alopezrivera/hopping_leg/docs/reference/source/chapters/2.hopping_control.rst

Hopping Control
===============

Hopping can be simplified with the Spring Loaded Inverted Pendulum (SLIP) model, in which a mass is mounted on a massless spring :cite:p:`Tedrake`. Due to this spring, the energy in the system stays constant. By adding or removing energy into the system, e.g., by applying some force to the spring, the jumping height can be controlled.

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

Gain Scheduling Control
-----------------------

The gain scheduling control uses Cartesian stiffness control to mirror the behaviour of the spring in the SLIP model. For this, a high stiffness is necessary to reapply sufficient energy into the system. To be able to lift-off and to counteract dissipation, the desired leg length during the lift-off phase can be increased and/or a feed forward force can be applied.

Energy Shaping Control
----------------------

The advantage of energy shaping control is, that we can control the jumping height by applying energy to the system until the desired energy :math:`E_{des}`, which is needed to jump at a desired height :math:`h_{des}`, is reached.
With the simplification, that we assume all mass `m` in the shoulder of the jumping leg the desired energy can be calculated with:

.. math::

    E_{des} = m g h_{des}

The used approach is non-continuous energy shaping, where we just observe the reached energy, which is: 

.. math::

    E \propto k F_e

and hence:

.. math:: 

    \dot E \propto \dot k F_e

Thus, we can add energy to the system by increasing `k` and remove energy by decreasing it. To control `k` the following update rule can be used:

.. math::

    k_{i+1} = k_{i}  (\frac{E_{des}}{E})^2
