alopezrivera/hopping_leg/docs/report/figures/hopping_leg.pdf

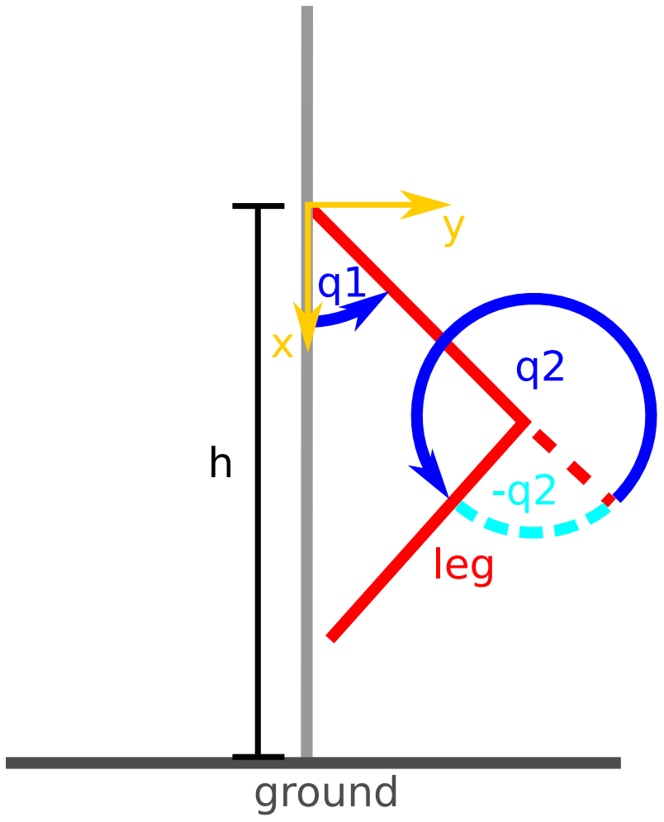
[picture p50: figure]
ground; leg
