alopezrivera/hopping_leg/docs/report/figures/hopping_leg_seq.pdf

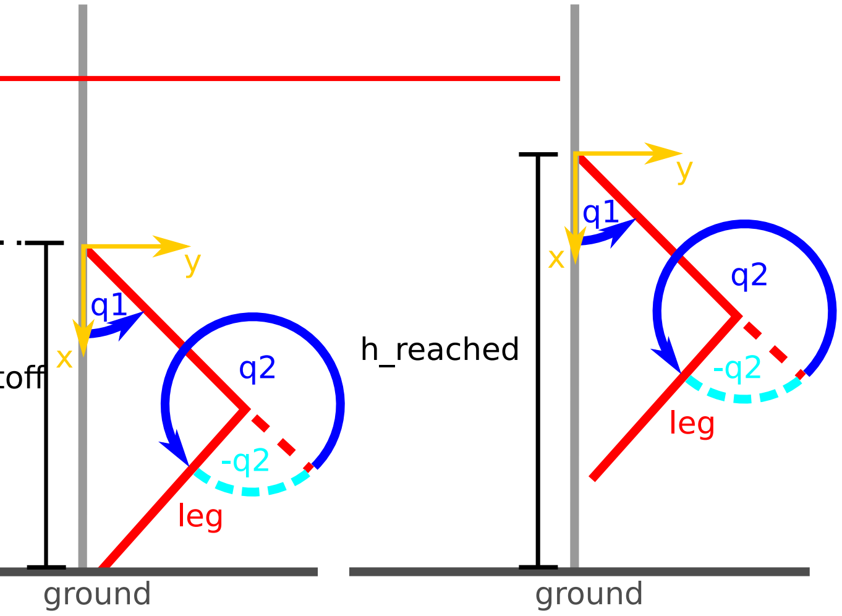
[picture p51: figure]
h_reached; ground; leg; toff
