alopezrivera/hopping_leg/hopping_leg/model/leg/without_rails/urdf/v6.pdf

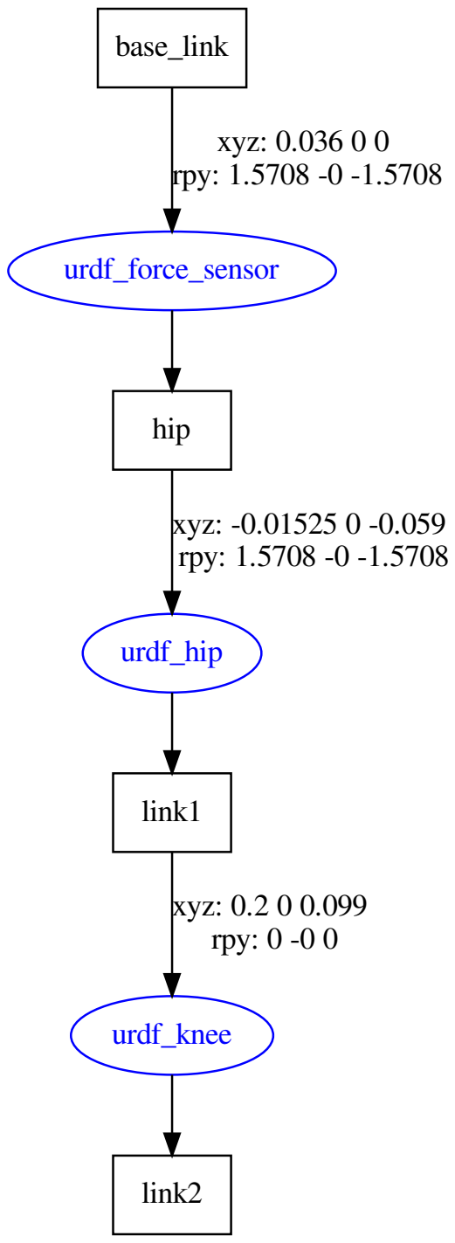
[picture p52: figure]
base_link; urdf_force_sensor; xyz: 0.036 0 0 rpy: 1.5708 -0 -1.5708; hip; urdf_hip; xyz: -0.01525 0 -0.059 rpy: 1.5708 -0 -1.5708; link1; urdf_knee; xyz: 0.2 0 0.099 rpy: 0 -0 0; link2
