alopezrivera/hopping_leg/docs/report/figures/sim0.4m/trajectoryexport.csv

time | shoulder_pos | elbow_pos | shoulder_vel | elbow_vel | shoulder_torque | elbow_torque
0.0014285714285714286 | -0.8964198657500071 | 1.783805794860055 | -3.82780511974532e-08 | -5.725540935109707e-07 | 1.275737367589555 | 4.722162462507789
0.002857142857142857 | -0.8972408415099087 | 1.7915024078758204 | -0.5746830319311426 | 5.387629111035757 | -0.17276516975831765 | -12.0
0.004285714285714286 | -0.8975892532870292 | 1.791522378884535 | -0.24388824398438447 | 0.013979706100228029 | 0.022556355161053598 | -12.0
0.005714285714285714 | -0.8975786801055714 | 1.7911083138747825 | 0.007401227020496837 | -0.28984550682670474 | 0.014718222825496464 | -12.0
0.007142857142857143 | -0.8972522583984869 | 1.790264468493122 | 0.22849519495919002 | -0.5906917671624932 | 0.009083692138998139 | -12.0
0.008571428571428572 | -0.8966414498656381 | 1.788993654238625 | 0.42756597299414256 | -0.8895699781477635 | 0.0050646211520992855 | -12.0
0.01 | -0.8957689195122812 | 1.7872975325958451 | 0.6107712473498346 | -1.187285149945966 | 0.0022198649754542436 | -12.0
0.011428571428571429 | -0.894650724335926 | 1.7851768291151866 | 0.7827366234486945 | -1.4844924364610002 | 0.0002199387344420817 | -12.0
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
