alopezrivera/hopping_leg/docs/report/figures/sim0.4m/acceleration.png

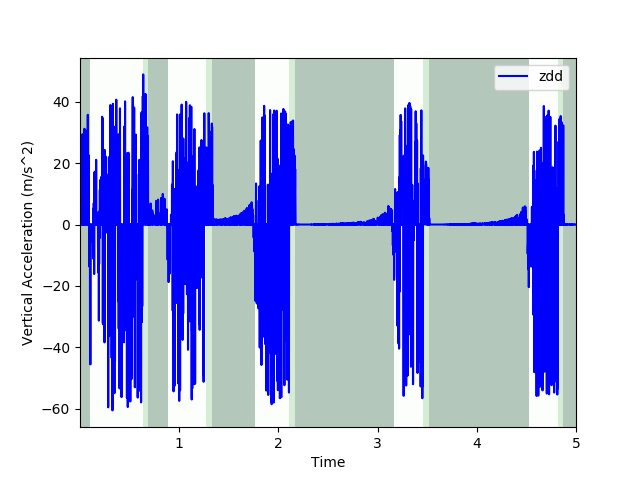
docs/report/figures/sim0.4m/acceleration.png
