alopezrivera/hopping_leg/docs/report/figures/sim0.4m/joint_velocities.png

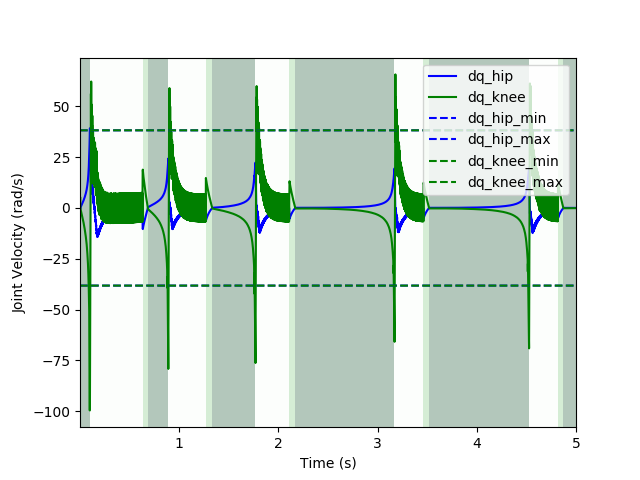
docs/report/figures/sim0.4m/joint_velocities.png
