alopezrivera/hopping_leg/docs/report/figures/sim0.4m/trajectory.png

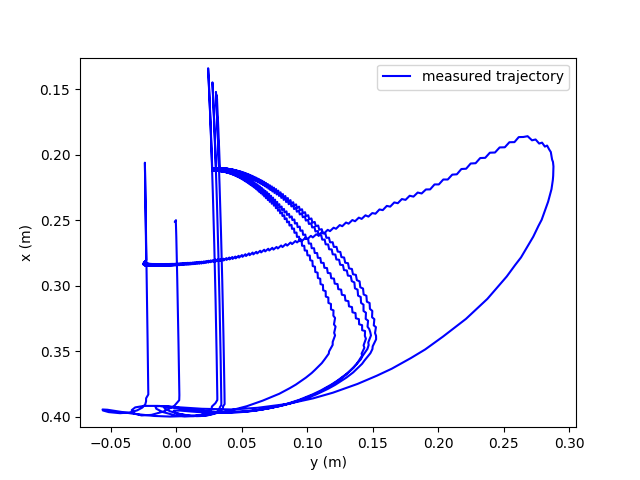
docs/report/figures/sim0.4m/trajectory.png
