alopezrivera/hopping_leg/docs/report/figures/sim0.4m/velocity.png

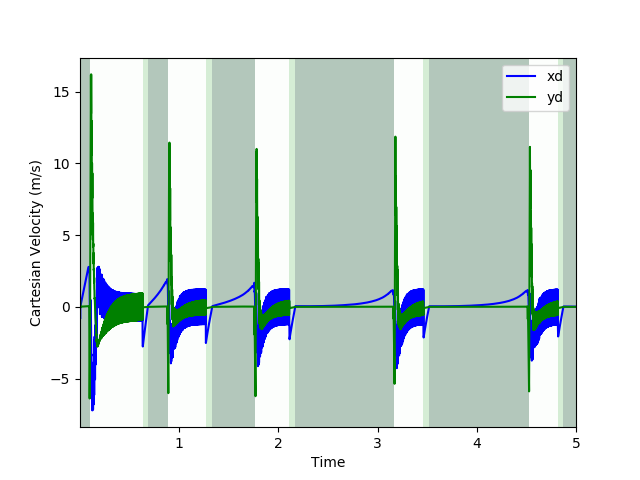
docs/report/figures/sim0.4m/velocity.png
