alopezrivera/hopping_leg/docs/report/figures/sim0.5m/acceleration.png

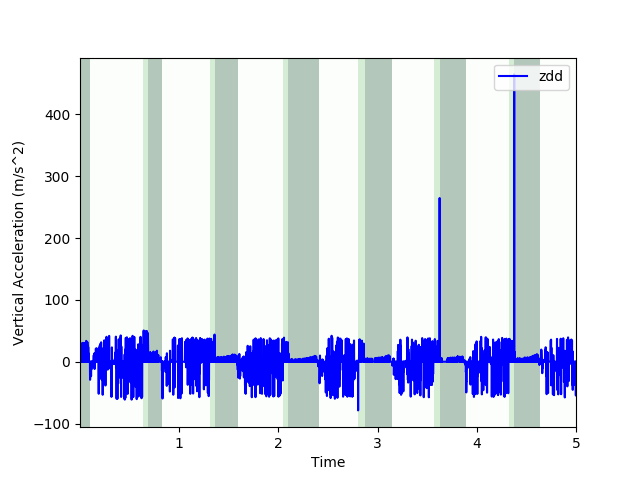
docs/report/figures/sim0.5m/acceleration.png
