alopezrivera/hopping_leg/docs/report/figures/sim0.5m/estimated_height.png

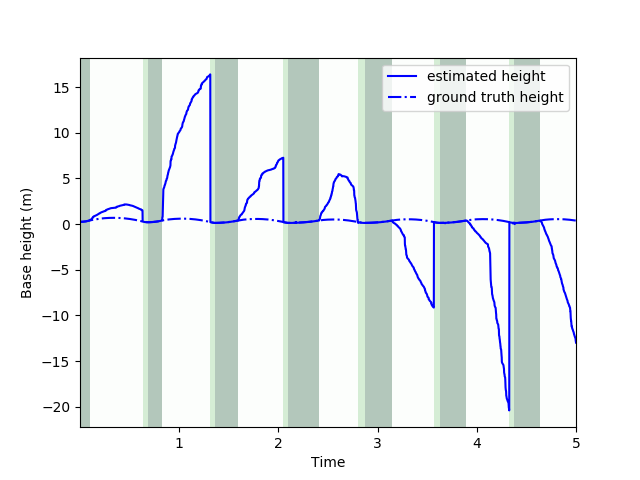
docs/report/figures/sim0.5m/estimated_height.png
