alopezrivera/hopping_leg/docs/report/figures/sim0.5m/joint_angles.png

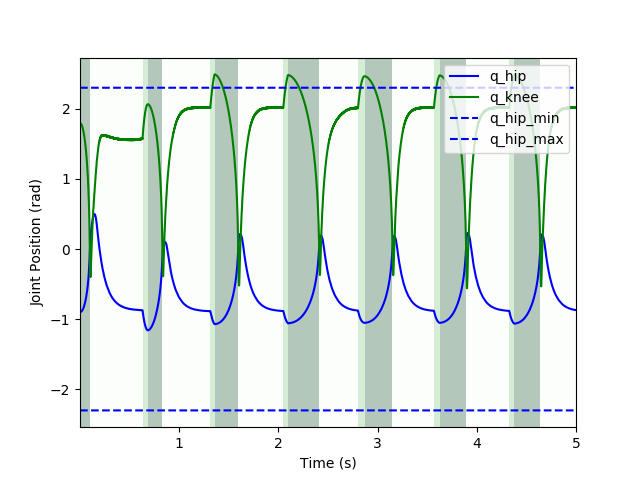
docs/report/figures/sim0.5m/joint_angles.png
