alopezrivera/hopping_leg/docs/report/figures/sim0.5m/joint_velocities.png

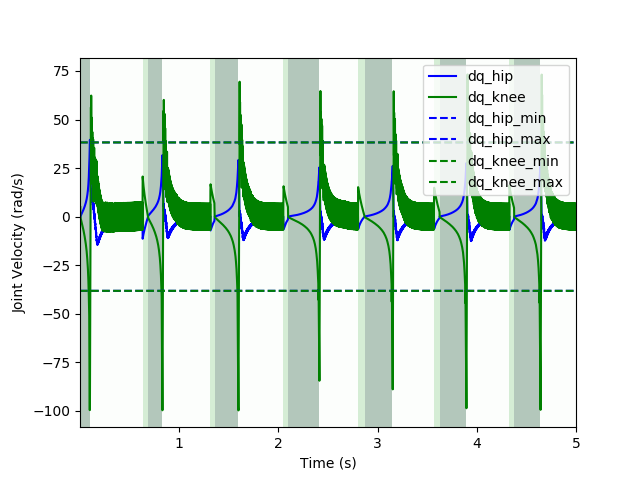
docs/report/figures/sim0.5m/joint_velocities.png
