alopezrivera/hopping_leg/docs/report/figures/sim0.5m/position.png

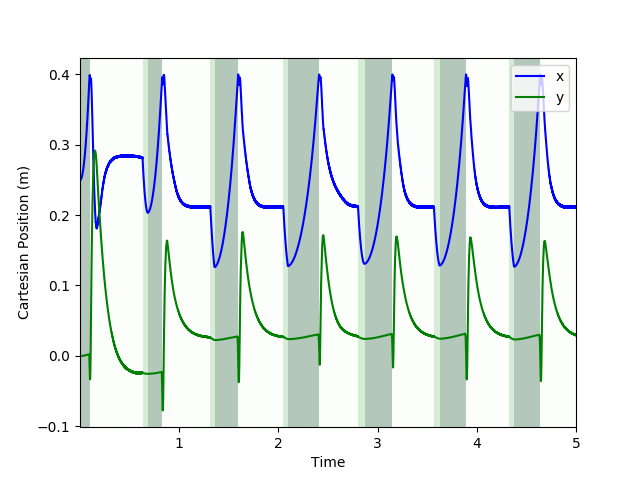
docs/report/figures/sim0.5m/position.png
