alopezrivera/hopping_leg/docs/report/figures/sim0.5m/trajectory.png

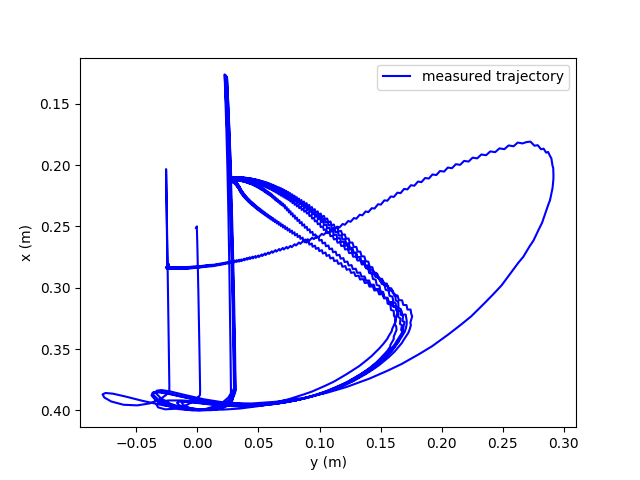
docs/report/figures/sim0.5m/trajectory.png
