alopezrivera/hopping_leg/docs/report/figures/sim0.5m/velocity.png

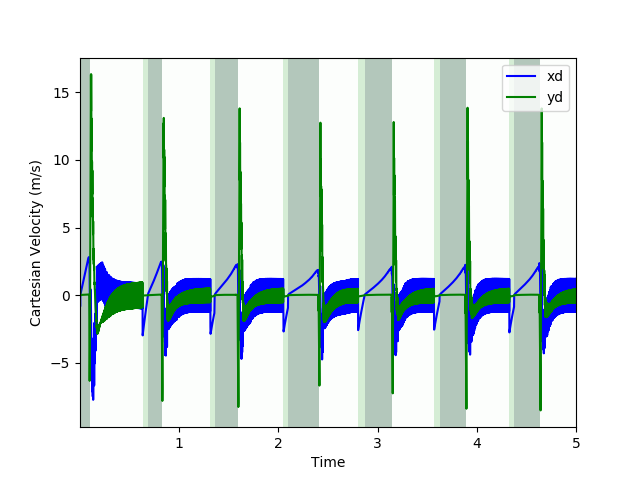
docs/report/figures/sim0.5m/velocity.png
