alopezrivera/hopping_leg/docs/report/figures/sim0.6m/acceleration.png

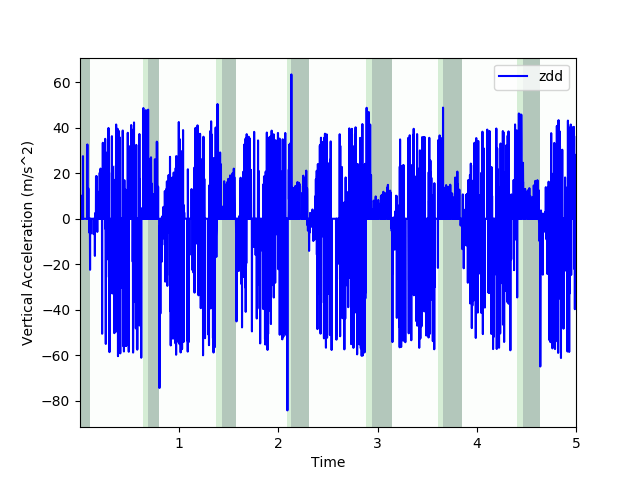
docs/report/figures/sim0.6m/acceleration.png
