alopezrivera/hopping_leg/docs/report/figures/sim0.6m/estimated_height.png

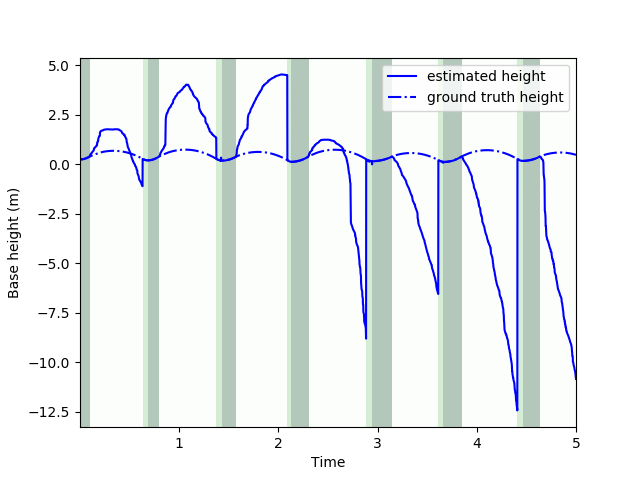
docs/report/figures/sim0.6m/estimated_height.png
