alopezrivera/hopping_leg/docs/report/figures/sim0.6m/joint_angles.png

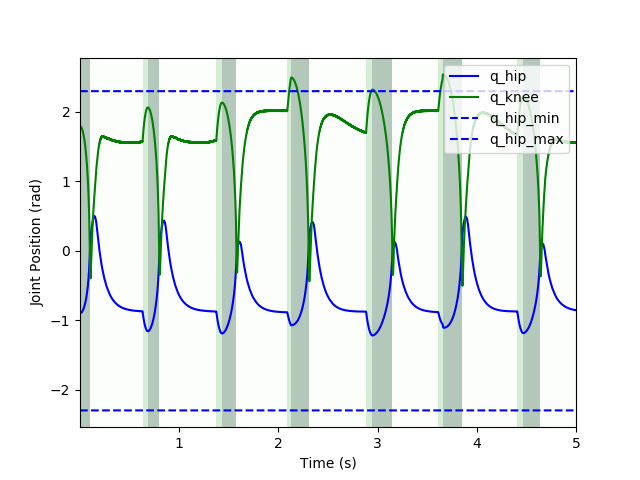
docs/report/figures/sim0.6m/joint_angles.png
