alopezrivera/hopping_leg/docs/report/figures/sim0.6m/position.png

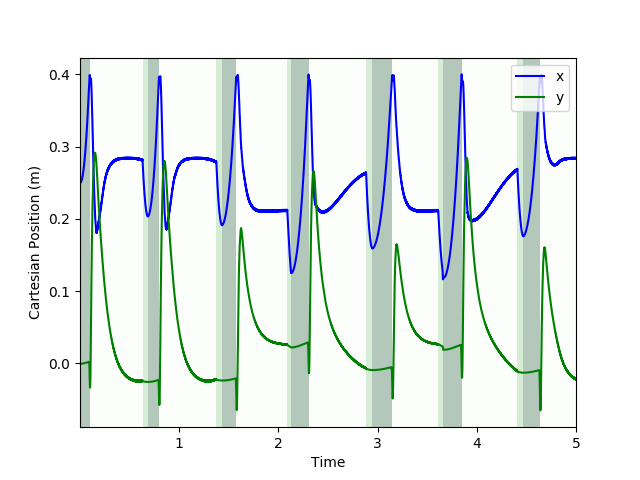
docs/report/figures/sim0.6m/position.png
