alopezrivera/hopping_leg/docs/report/figures/sim0.6m/reaction_forces.png

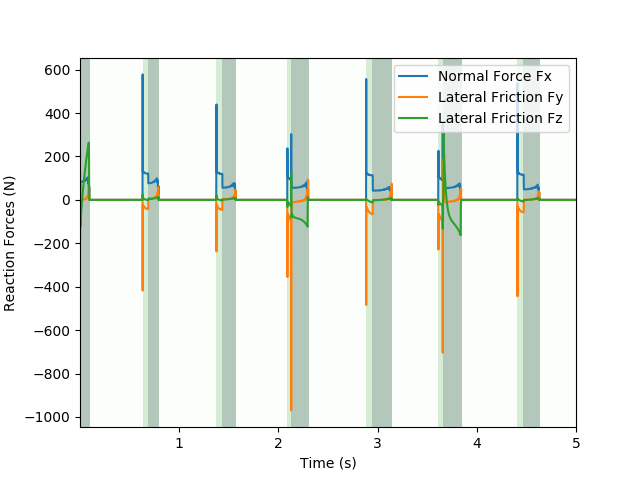
docs/report/figures/sim0.6m/reaction_forces.png
