alopezrivera/hopping_leg/docs/report/figures/sim0.6m/trajectory.png

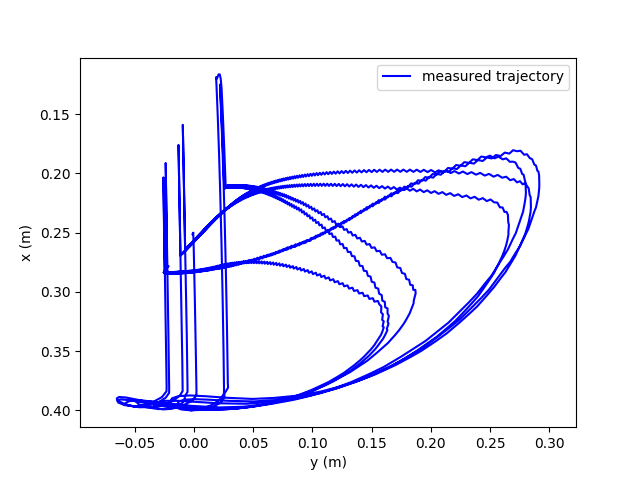
docs/report/figures/sim0.6m/trajectory.png
