alopezrivera/hopping_leg/docs/report/figures/sim0.6m/velocity.png

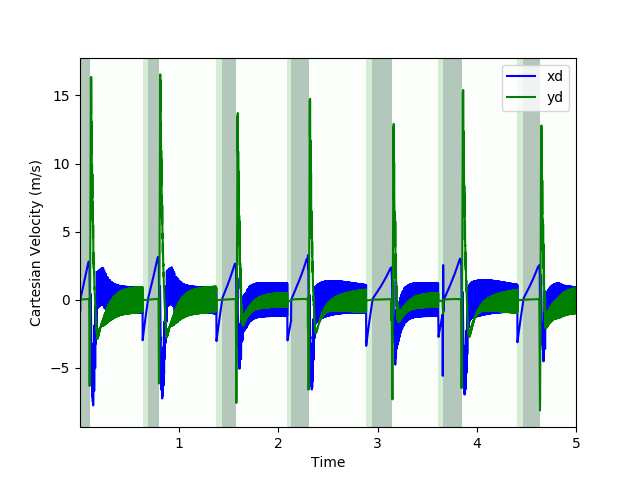
docs/report/figures/sim0.6m/velocity.png
