alopezrivera/hopping_leg/figures/plant/coordinates.png

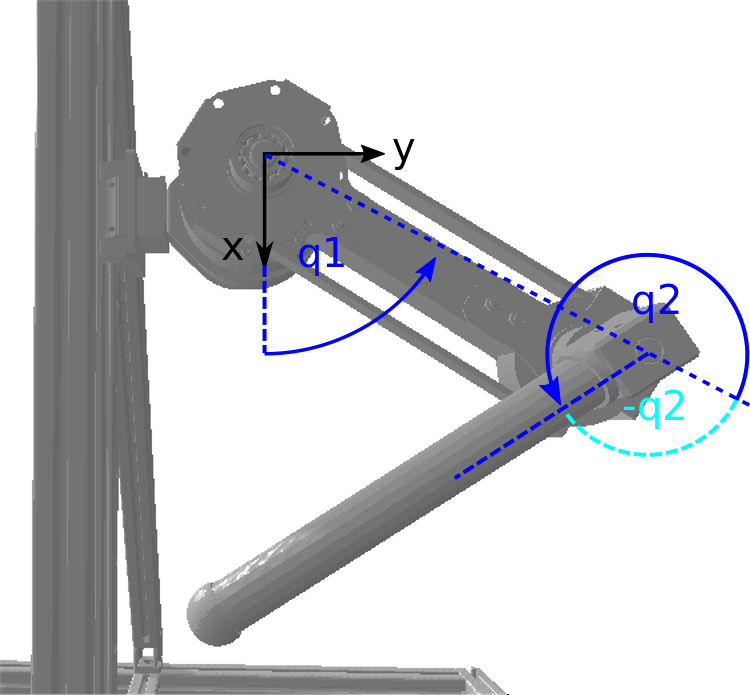
figures/plant/coordinates.png
