alopezrivera/hopping_leg/hopping_leg/controllers/OC_FDDP/comtraj.png

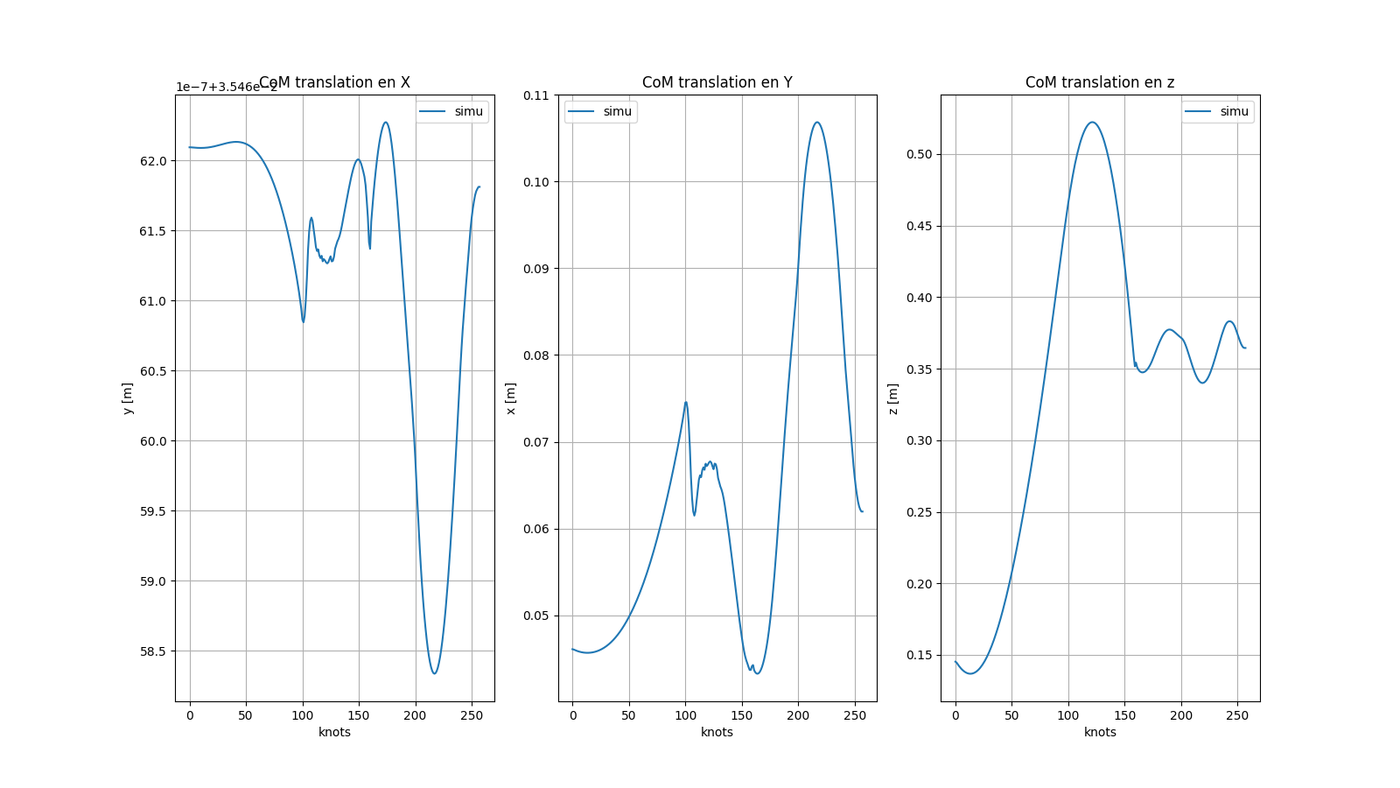
hopping_leg/controllers/OC_FDDP/comtraj.png
