alopezrivera/hopping_leg/hopping_leg/controllers/OC_FDDP/jointRotations.png

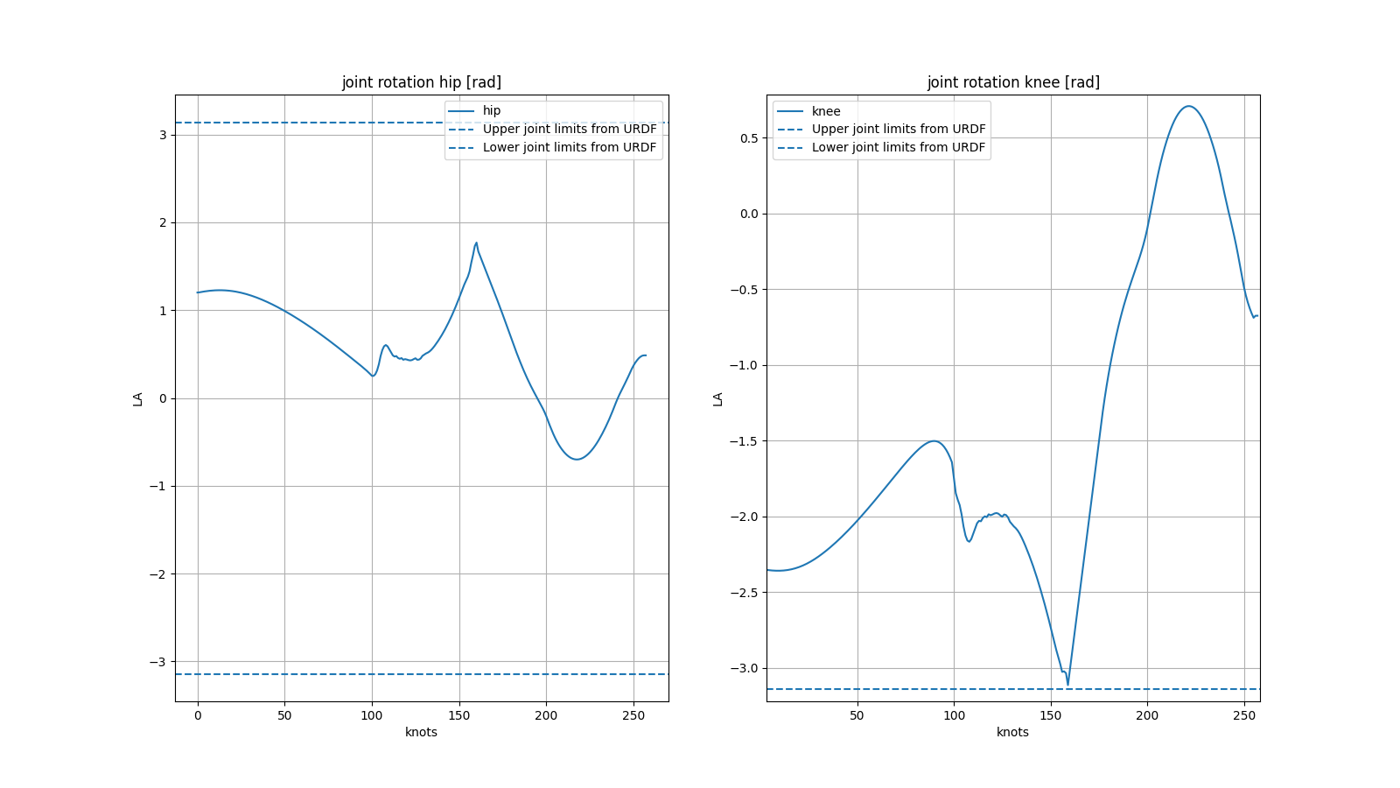
hopping_leg/controllers/OC_FDDP/jointRotations.png
