alopezrivera/hopping_leg/hopping_leg/controllers/OC_FDDP/jointVelocities.png

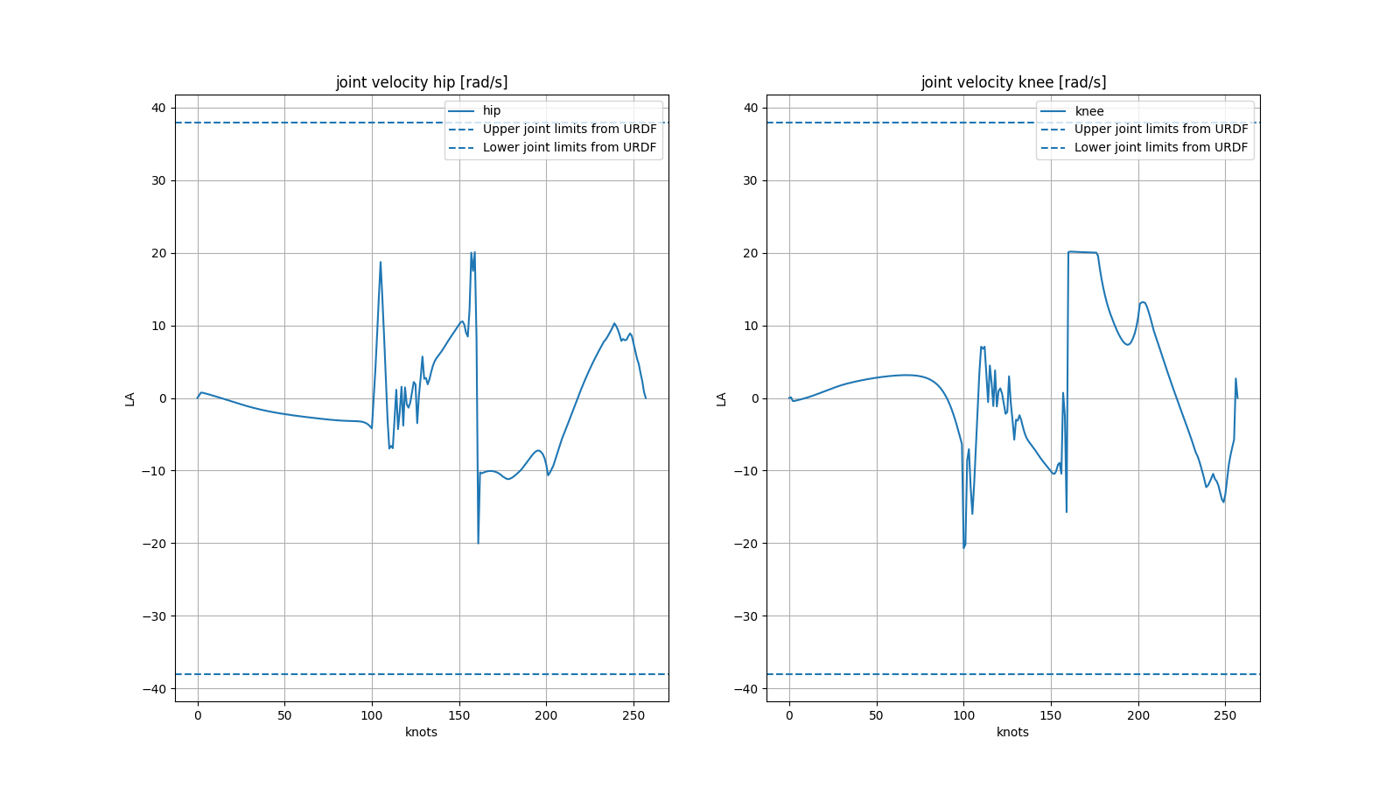
hopping_leg/controllers/OC_FDDP/jointVelocities.png
