alopezrivera/hopping_leg/hopping_leg/controllers/OC_FDDP/torques.png

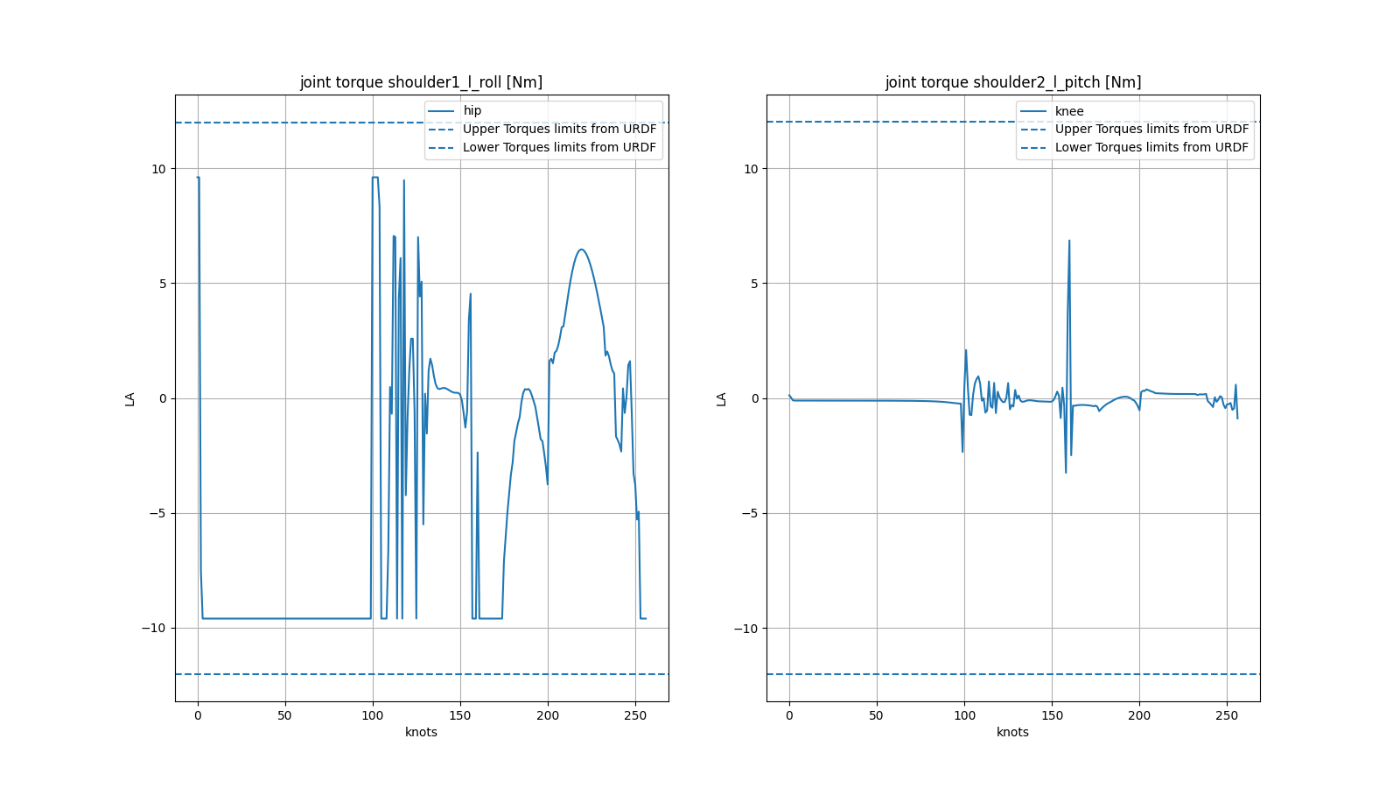
hopping_leg/controllers/OC_FDDP/torques.png
