alopezrivera/hopping_leg/hopping_leg/model/leg/with_rails/meshes/hip.STL

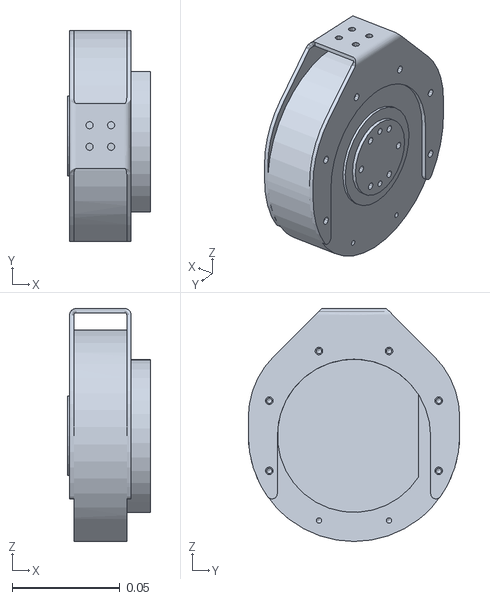
[picture p79: CAD file, 2022-03-21]
hopping_leg/model/leg/with_rails/meshes/hip.STL
0.0385 x 0.098 x 0.108
