alopezrivera/hopping_leg/hopping_leg/model/leg/with_rails2/meshes/link_1.STL

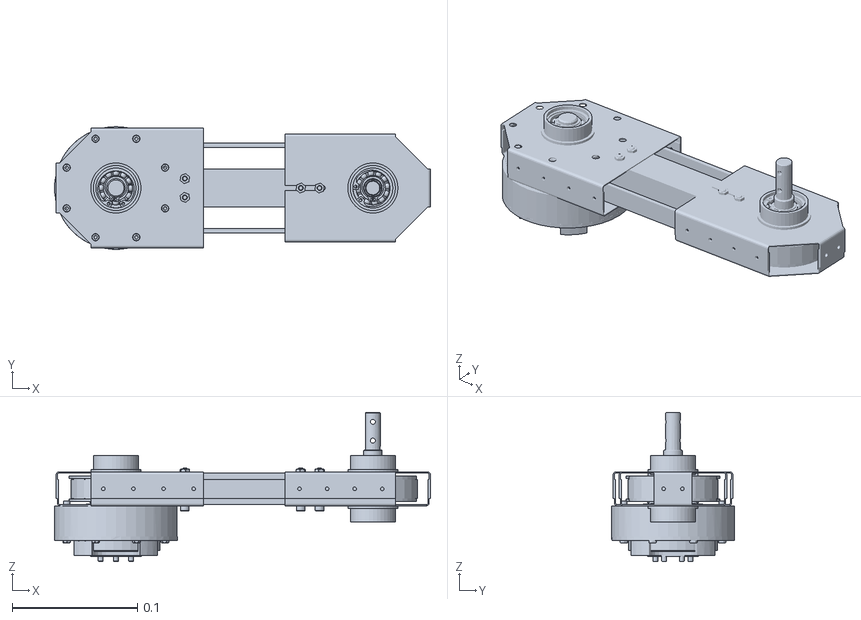
[picture p80: CAD file, 2022-03-21]
hopping_leg/model/leg/with_rails2/meshes/link_1.STL
0.3 x 0.098 x 0.119
