alopezrivera/hopping_leg/hopping_leg/model/leg/with_rails/meshes/base_link.STL

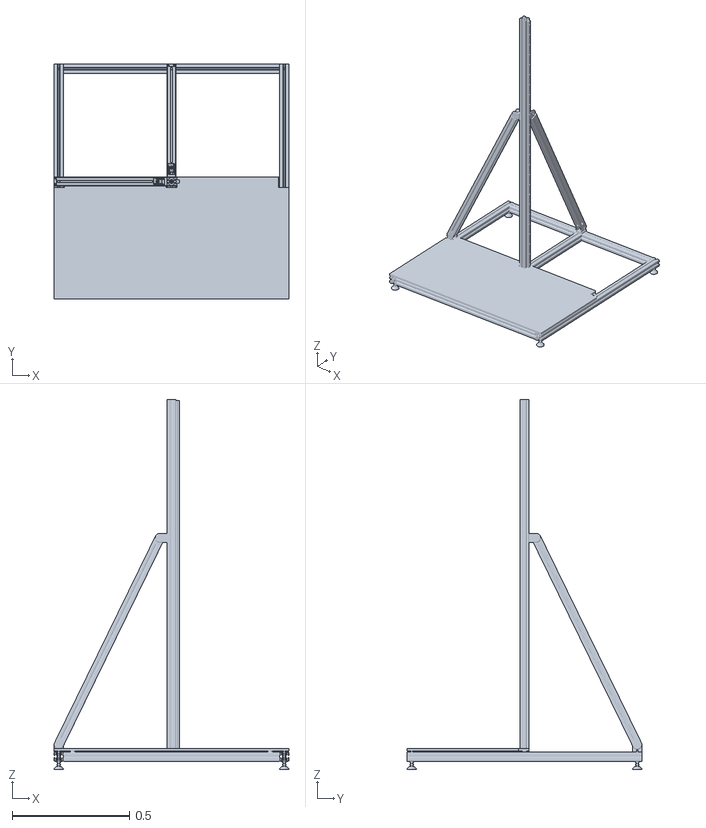
[picture p81: CAD file, 2022-03-21]
hopping_leg/model/leg/with_rails/meshes/base_link.STL
1 x 1.00 x 1.58
