alopezrivera/hopping_leg/hopping_leg/model/leg/without_rails/meshes/link2.STL

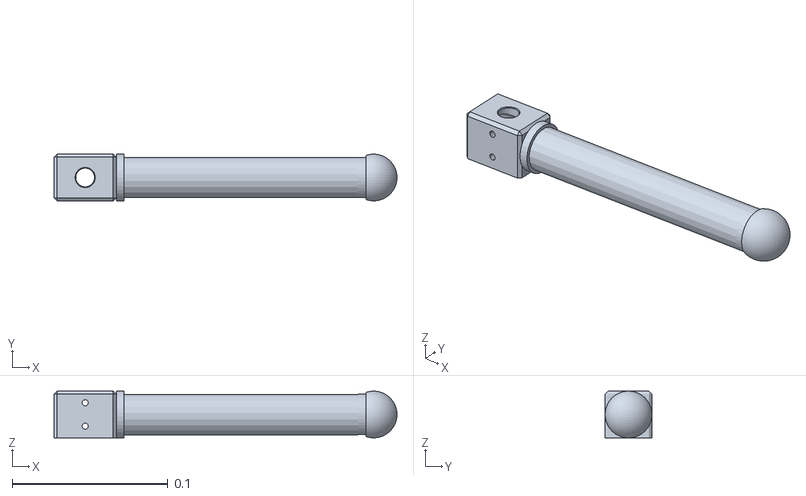
[picture p82: CAD file, 2022-03-21]
hopping_leg/model/leg/without_rails/meshes/link2.STL
0.22 x 0.03 x 0.03
