alopezrivera/hopping_leg/hopping_leg/model/leg/with_rails/meshes/slider.STL

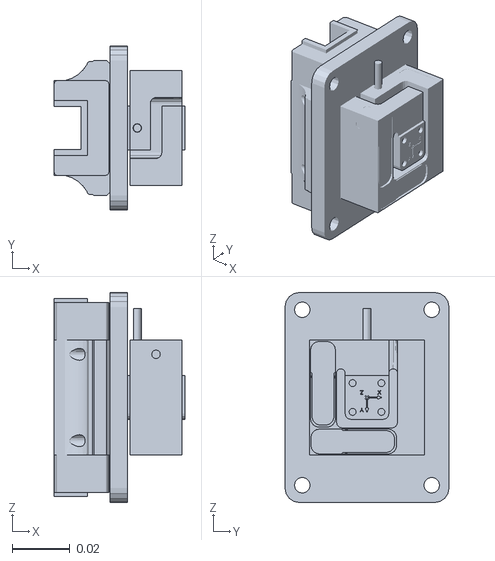
[picture p83: CAD file, 2022-03-21]
hopping_leg/model/leg/with_rails/meshes/slider.STL
0.0454 x 0.057 x 0.073
