alopezrivera/hopping_leg/hopping_leg/model/leg/with_rails/meshes/link_2.STL

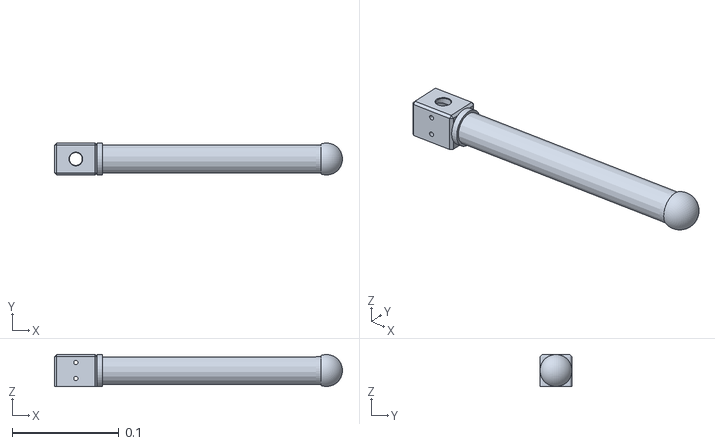
[picture p84: CAD file, 2022-03-21]
hopping_leg/model/leg/with_rails/meshes/link_2.STL
0.27 x 0.03 x 0.03
