alopezrivera/hopping_leg/hopping_leg/model/leg/without_rails/meshes/link1.STL

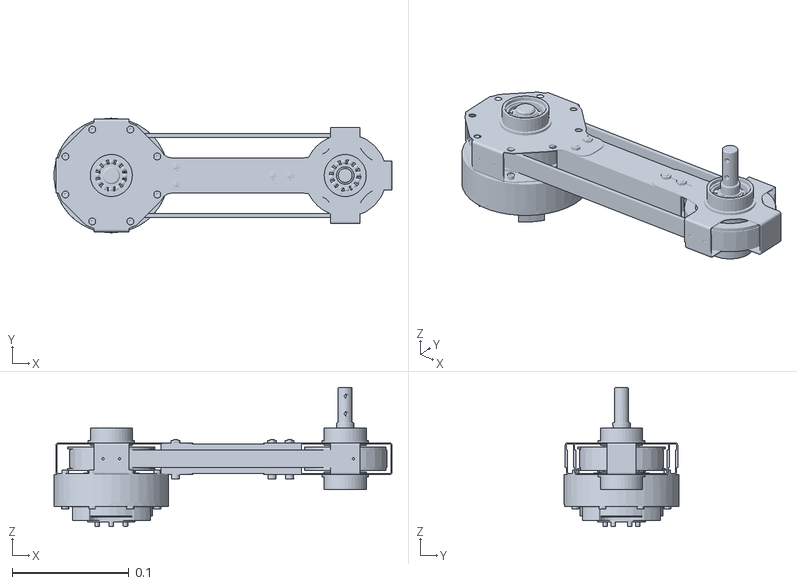
[picture p85: CAD file, 2022-03-21]
hopping_leg/model/leg/without_rails/meshes/link1.STL
0.289 x 0.098 x 0.119
