alopezrivera/hopping_leg/hopping_leg/model/leg/with_rails/meshes/link_1.STL

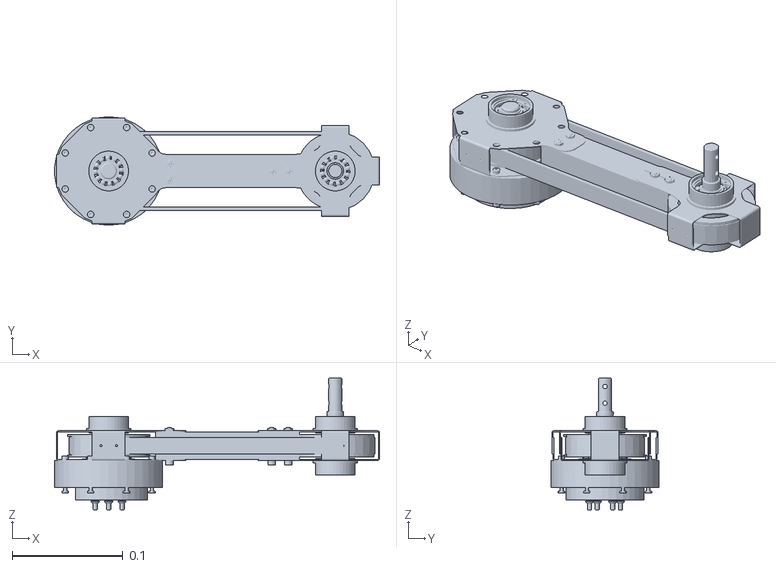
[picture p86: CAD file, 2022-03-21]
hopping_leg/model/leg/with_rails/meshes/link_1.STL
0.294 x 0.098 x 0.119
