alopezrivera/hopping_leg/hopping_leg/model/leg/with_rails2/meshes/hip.STL

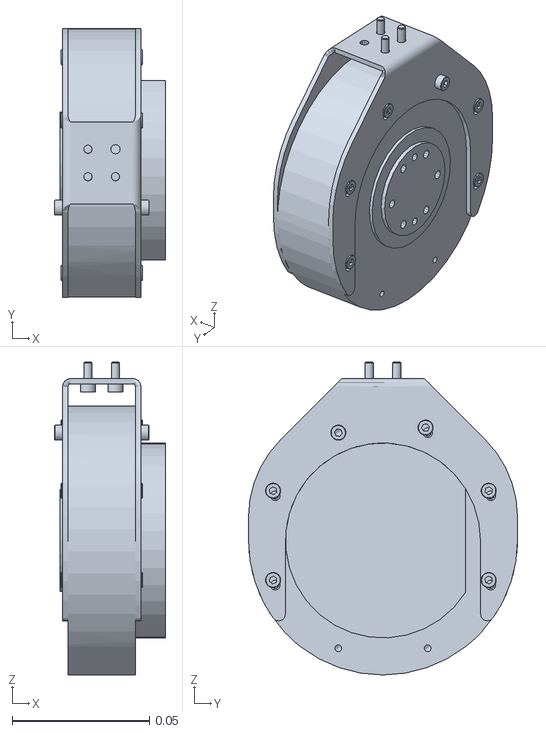
[picture p87: CAD file, 2022-03-21]
hopping_leg/model/leg/with_rails2/meshes/hip.STL
0.0405 x 0.098 x 0.114
