alopezrivera/hopping_leg/(list of files, cad)

Other CAD files:
hopping_leg/model/leg/without_rails/meshes/hip.STL
hopping_leg/model/leg/with_rails2/meshes/base_link.STL
hopping_leg/model/leg/with_rails2/meshes/link_2.STL
hopping_leg/model/leg/without_rails/meshes/base_link.STL
hopping_leg/model/leg/with_rails2/meshes/slider.STL
