alopezrivera/hopping_leg/hopping_leg/model/leg/with_rails2/urdf/vertical_test.SLDASM.pdf

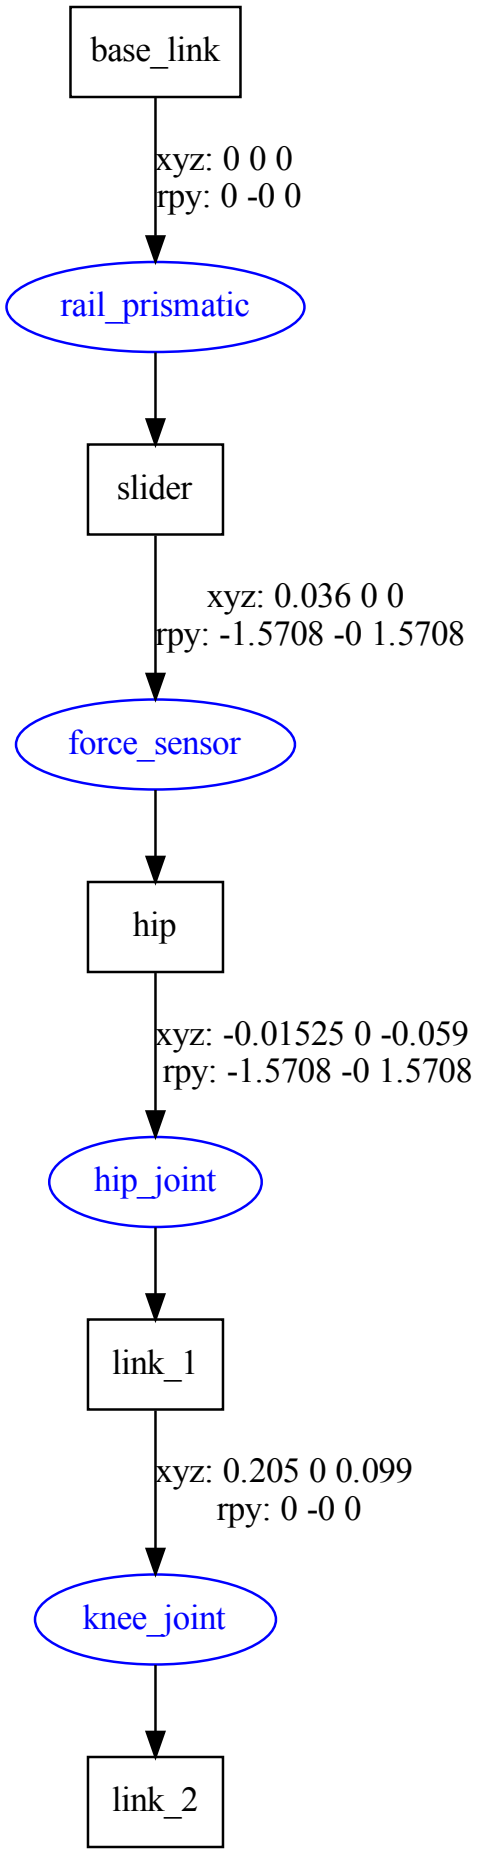
[picture p88: figure]
base_link; rail_prismatic; xyz: 0 0 0 rpy: 0 -0 0; slider; force_sensor; xyz: 0.036 0 0 rpy: -1.5708 -0 1.5708; hip; hip_joint; xyz: -0.01525 0 -0.059 rpy: -1.5708 -0 1.5708; link_1; knee_joint; xyz: 0.205 0 0.099 rpy: 0 -0 0; link_2
