alopezrivera/hopping_leg/hopping_leg/real/tmotors/measured_data.csv

time | shoulder_pos | shoulder_vel | shoulder_torque | elbow_pos | elbow_vel | elbow_torque
5.917339086532592773e+00 | 1.039009689478902487e+00 | -7.692307692308020250e-02 | -5.318681318681335313e-01 | -2.187312123292898036e+00 | -1.098901098901450268e-02 | 3.793406593406594141e+00
5.920986175537109375e+00 | 1.039009689478902487e+00 | -7.692307692308020250e-02 | -1.802197802197795795e-01 | -2.190226596475170595e+00 | -1.285714285714284699e+00 | 8.219780219780226105e-01
5.924085378646850586e+00 | 1.039009689478902487e+00 | -1.153846153846153300e+00 | -4.821978021978022610e+00 | -2.190226596475170595e+00 | 1.395604395604394199e+00 | 9.024175824175824090e+00
5.926110267639160156e+00 | 1.036095216296629928e+00 | -1.791208791208788398e+00 | -4.830769230769231370e+00 | -2.184397650110625477e+00 | 3.439560439560437999e+00 | 9.692307692307693401e+00
5.927685022354125977e+00 | 1.033180743114371580e+00 | -1.923076923076919797e+00 | -4.909890109890110210e+00 | -2.178568703746094570e+00 | 4.010989010989014503e+00 | 1.051868131868132039e+01
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
