alopezrivera/hopping_leg/docs/report/figures/sim0.5m/results.csv

time | x | y | xd | yd | zdd | h | q1 | q2 | q1d | q2d | tau1 | tau2 | Fx | Fy | Fz | basepos | basepos_desired
0.0014285714285714286 | 0.2511703176953811 | -0.0011345360839407348 | 8.875098253996313e-08 | -8.192115841243114e-08 | 0.0 | 0.2511703176953811 | -0.8964198657500071 | 1.783805794860055 | -3.82780511974532e-08 | -5.725540935109707e-07 | 1.275737367589555 | 4.722162462507789 | 22.619959898402595 | -103.50649141289705 | -201.1284783811731 | 0.25643399727041316 | 0.5
0.002857142857142857 | 0.24997274018032628 | -0.00037236906117954494 | -0.8404114830684527 | 0.5309781986730198 | 0.0 | 0.24997274018032628 | -0.8972408415099087 | 1.7915024078758204 | -0.5746830319311426 | 5.387629111035757 | -0.17276516975831888 | -12.0 | 0.0 | 0.0 | 0.0 | 0.2564099909166173 | 0.5
0.004285714285714286 | 0.24996948165018487 | -0.0004569606807250104 | -0.002290998955764907 | -0.05921337778265055 | 0.0 | 0.24996948165018487 | -0.8975892532870292 | 1.791522378884535 | -0.24388824398438447 | 0.013979706100228029 | 0.02255635516105237 | -12.0 | 59.716738637555416 | -9.106887079184055 | -126.44951532627607 | 0.2564494572824254 | 0.5
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
