alopezrivera/hopping_leg/archive/real/FDDP/results/withoutRAILPZ/2hops/logs/logBase.csv

t[s] | Z | vz | vzd
0.0 | 0.162 | 0.0 | -2.312802116907317
0.005 | 0.1619421799628704 | -0.011564007425924708 | -2.1321630281167856
0.01 | 0.16183105586352156 | -0.022224819869762893 | -1.6117332431869862
0.015 | 0.16167963844587666 | -0.030283483528979874 | -1.0788895576540405
0.02 | 0.16150124880137826 | -0.03567792889968208 | -0.5332052238008806
0.025 | 0.16130952903763748 | -0.038343952748154934 | -0.4269722150877726
0.03 | 0.16110713497907578 | -0.04047881171234331 | -0.639979181842758
0.035 | 0.1608887414506634 | -0.04367870568247503 | -0.6628872232040983
0.04 | 0.16065377575046022 | -0.04699314004063734 | -0.532771924987749
0.045 | 0.16040549075996774 | -0.04965699809849425 | -0.27809342153254235
0.05 | 0.1601502534407669 | -0.05104746384017188 | 0.0788263091043433
0.055 | 0.15989698678506117 | -0.05065333114114345 | 0.5203723046793947
0.06 | 0.15965672944161452 | -0.04805146868933292 | 1.0326187288753488
0.065 | 0.1594422875698375 | -0.04288837435540239 | 1.6013943669456978
0.07 | 0.15926788055941113 | -0.034881402085275126 | 2.218251891808613
0.075 | 0.15914892984708245 | -0.02379014246573598 | 2.8866071043237014
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
