alopezrivera/hopping_leg/archive/real/FDDP/results/withoutRAILPZ/2hops/logs/logBase_interp.csv

t[s] | Z | vz | vzd
0.0 | 0.162 | 0.0 | -2.312802116907317
0.0012500000000000005 | 0.16199125949747795 | -0.0028564172567281084 | -2.324433348031207
0.002500000000000001 | 0.16197857270455804 | -0.005758606937924678 | -2.2934542673105645
0.0037500000000000003 | 0.16196214455007676 | -0.008672495006640085 | -2.226989339190665
0.005 | 0.1619421799628704 | -0.011564007425924708 | -2.1321630281167856
0.00625 | 0.16191888387177533 | -0.014399070158828924 | -2.016099798534202
0.007500000000000001 | 0.16189246120562792 | -0.017143609168403105 | -1.8859241148881896
0.008750000000000003 | 0.16186311689326457 | -0.019763550417697638 | -1.7487604416240257
0.01 | 0.16183105586352156 | -0.02222481986976289 | -1.6117332431869862
0.01125 | 0.16179648140927277 | -0.02450087137143426 | -1.4799577820073229
0.0125 | 0.16175959027954168 | -0.026595270304687224 | -1.3505125124551902
0.01375 | 0.16172057758738934 | -0.028519109935282262 | -1.2184666868857195
0.015 | 0.16167963844587666 | -0.030283483528979874 | -1.0788895576540405
0.01625 | 0.1616369793610949 | -0.03189494913356674 | -0.9297652548120499
0.0175 | 0.16159285241125626 | -0.0333419239249343 | -0.7807374191987084
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
