alopezrivera/hopping_leg/archive/real/FDDP/results/withoutRAILPZ/2hops/logs/logJointSpace.csv

t[s] | q_urdf_hip | q_urdf_knee | qd_urdf_hip | qd_urdf_knee | qdd_urdf_hip | qdd_urdf_knee | Tau_urdf_hip | Tau_urdf_knee
0.0 | 1.2 | -2.35 | 0.0 | 0.0 | 6.448983790408647 | 75.56649508109956 | -5.249641003464004 | -0.01079653820049633
0.005 | 1.2001612245494184 | -2.3481108371667117 | 0.032244909883683025 | 0.37783256665767284 | 5.706719012240001 | -7.051924196823677 | -5.5650723735089045 | -0.08076392399562894
0.01 | 1.2004651170329348 | -2.346397972417708 | 0.060778496703284196 | 0.34257294980069986 | 4.242572830827157 | -5.3631669948432545 | -5.882889895062959 | -0.08324877737599636
0.015 | 1.2008750737981557 | -2.3448191868360526 | 0.08199135304418748 | 0.31575711633111553 | 2.7324545574751937 | -3.647103828909394 | -6.206137968496124 | -0.08579920474815633
0.02 | 1.2013533418903823 | -2.343331578846404 | 0.09565361844532619 | 0.29752159792972177 | 1.1737600602261864 | -1.8785249577158538 | -6.535100562810853 | -0.08839421012686698
0.025 | 1.2018609539494034 | -2.341890933980981 | 0.10152241180420221 | 0.2881289730847203 | 0.882378869430795 | -1.7985581504963193 | -6.582370617124635 | -0.08906341796519573
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
