alopezrivera/hopping_leg/archive/real/FDDP/results/withoutRAILPZ/2hops/logs/logJointSpace_interp.csv

time | shoulder_pos | shoulder_vel | shoulder_torque | elbow_pos | elbow_vel | elbow_torque
0 | 1.2 | 0 | -5.249641003464 | -2.35 | 0 | -0.010796538200496
0.00125 | 1.20002491540919 | 0.008155372706705 | -5.32706210247699 | -2.34950884283097 | 0.162422770896996 | -0.039289373393525
0.0025 | 1.20006047522941 | 0.016296323123168 | -5.40567208606865 | -2.34903070873389 | 0.273966791443116 | -0.059557834884607
0.00375 | 1.20010610357228 | 0.024350339448967 | -5.48512437086922 | -2.34856492956155 | 0.342985557932096 | -0.072937494482417
0.005 | 1.20016122454942 | 0.032244909883683 | -5.5650723735089 | -2.34811083716671 | 0.377832566657673 | -0.080763923995629
0.00625 | 1.20022526227244 | 0.039907522626894 | -5.64516951061791 | -2.34766776340214 | 0.386861313913585 | -0.084372695232918
0.0075 | 1.20029764085295 | 0.047265665878178 | -5.72506919882644 | -2.3472350401206 | 0.378425295993568 | -0.085099380002959
0.00875 | 1.20037778440258 | 0.054246827837115 | -5.80442485476472 | -2.34681199917487 | 0.360878009191361 | -0.084279550114427
0.01 | 1.20046511703293 | 0.060778496703284 | -5.88288989506296 | -2.34639797241771 | 0.3425729498007 | -0.083248777375996
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
