alopezrivera/hopping_leg/archive/real/FDDP/results/withoutRAILPZ/trial1/logs/logBase.csv

t[s] | Z | vz | vzd
0.0 | 0.162 | 0.0 | -25.16359048183852
0.005 | 0.16137091023795405 | -0.1258179524091926 | -25.720833400735366
0.01 | 0.16009879964088972 | -0.2544221194128694 | 0.9756033414192018
0.015 | 0.15885107912736085 | -0.2495441027057734 | 4.304686794328347
0.02 | 0.1577109757836902 | -0.22802066873413165 | 4.400267439979295
0.025 | 0.15668087912601902 | -0.20601933153423518 | 4.489711268402054
0.03 | 0.1557630252500579 | -0.18357077519222492 | 4.572629851727378
0.035 | 0.15495948712038995 | -0.16070762593358803 | 4.648658295023914
0.04 | 0.1542721654480976 | -0.13746433445846845 | 4.7175603034997025
0.045 | 0.15370278278339275 | -0.11387653294096994 | 4.781244843748787
0.05 | 0.15325293123978162 | -0.089970308722226 | 4.837306378562886
0.055 | 0.15292401235563458 | -0.06578377682941157 | 4.885806675101257
0.06 | 0.15271723863836506 | -0.04135474345390529 | 4.926826297382455
0.065 | 0.1526336355785301 | -0.016720611966993013 | 4.9604686654356485
0.07 | 0.15267404423533104 | 0.00808173136018523 | 4.9868630578637365
0.075 | 0.15283912446857856 | 0.033016046649503916 | 5.006166496384303
0.08 | 0.15312935886423568 | 0.058046879131425436 | 5.018564484148385
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
