alopezrivera/hopping_leg/archive/real/FDDP/results/withoutRAILPZ/trial1/logs/logJointSpace.csv

t[s] | q_urdf_hip | q_urdf_knee | qd_urdf_hip | qd_urdf_knee | qdd_urdf_hip | qdd_urdf_knee | Tau_urdf_hip | Tau_urdf_knee
0.0 | 1.2 | -2.35 | 0.0 | 0.0 | 72.05446329872257 | 17.986326708179718 | 9.600000000000001 | 0.11467547112058428
0.005 | 1.201801361582468 | -2.3495503418322956 | 0.36027231649361285 | 0.08993163354089859 | 73.83528386257467 | -100.25741442377375 | 9.600000000000001 | 0.02002335910957272
0.01 | 1.2054486052615005 | -2.3516071190251853 | 0.7294487358064863 | -0.4113554385779702 | -2.604781338188559 | -1.0381359714428982 | -7.535790727548412 | -0.10038169039990506
0.015 | 1.2090307294070783 | -2.353689849617361 | 0.7164248291155435 | -0.4165461184351847 | -12.327540452092308 | 11.423723051329716 | -9.600000000000001 | -0.11493842536535234
0.02 | 1.2123046650413538 | -2.3554869871332538 | 0.654787126855082 | -0.3594275031785361 | -12.753080262375079 | 11.87478100961141 | -9.600000000000001 | -0.11494756030269959
0.025 | 1.2152597736690698 | -2.356987255123906 | 0.5910217255432066 | -0.30005359813047905 | -13.154179896986534 | 12.298204391124273 | -9.600000000000001 | -0.11494895394058456
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
