alopezrivera/hopping_leg/hopping_leg/controllers/OC_FDDP/results/withoutRAILPZ/2hops/com.png

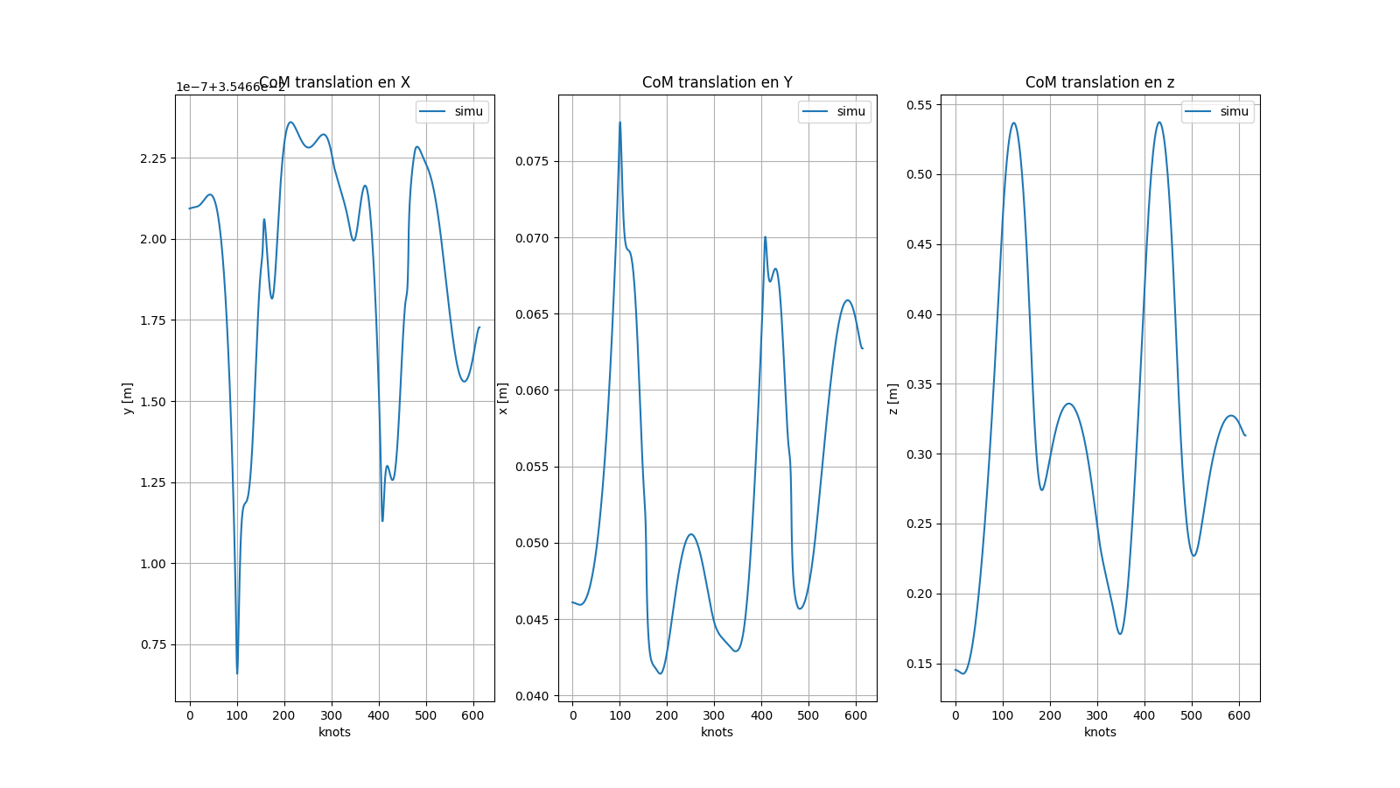
hopping_leg/controllers/OC_FDDP/results/withoutRAILPZ/2hops/com.png
