alopezrivera/hopping_leg/sim/results/20210722_hopping/cartesian_position_XY.png

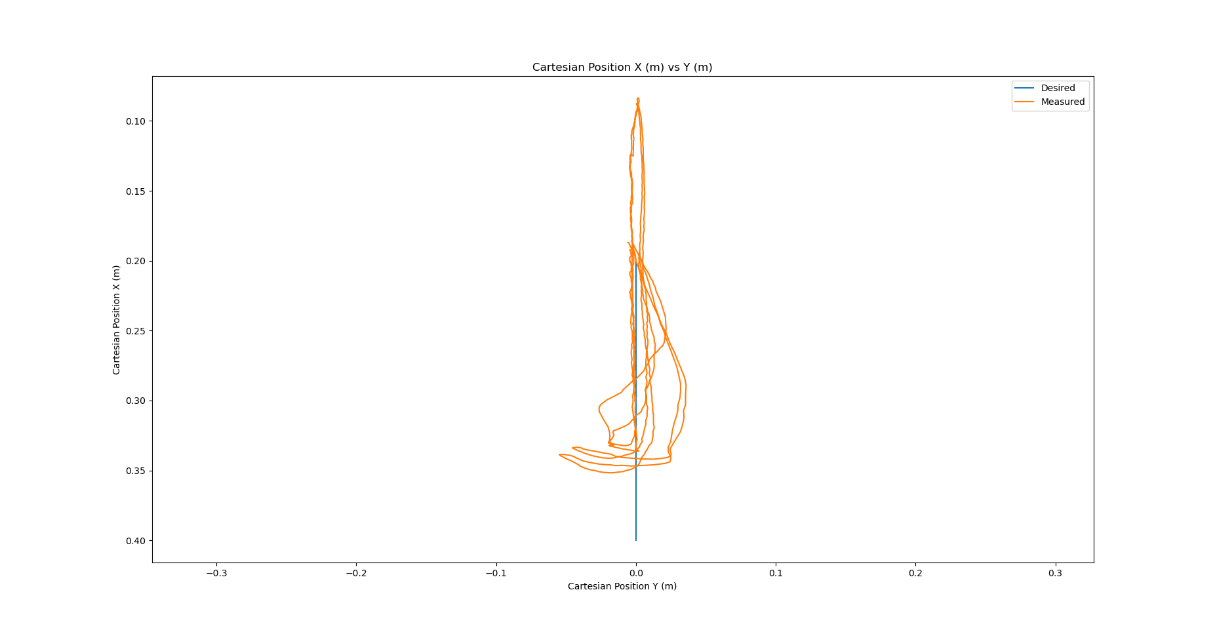
sim/results/20210722_hopping/cartesian_position_XY.png
