alopezrivera/hopping_leg/sim/results/20210722_hopping/filtered_torque.png

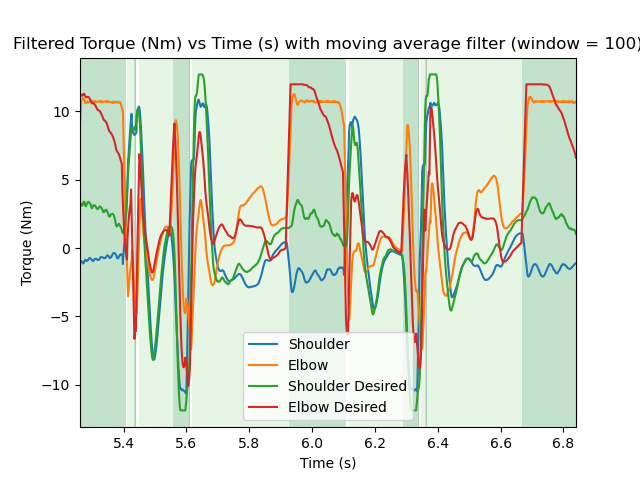
sim/results/20210722_hopping/filtered_torque.png
