alopezrivera/hopping_leg/sim/results/20210722_hopping/velocity.png

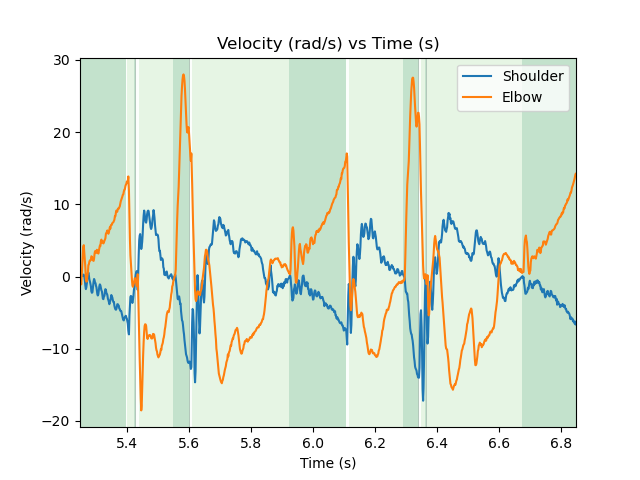
sim/results/20210722_hopping/velocity.png
