alopezrivera/hopping_leg/sim/results/20210722_hopping_correctphases/cartesian_position.png

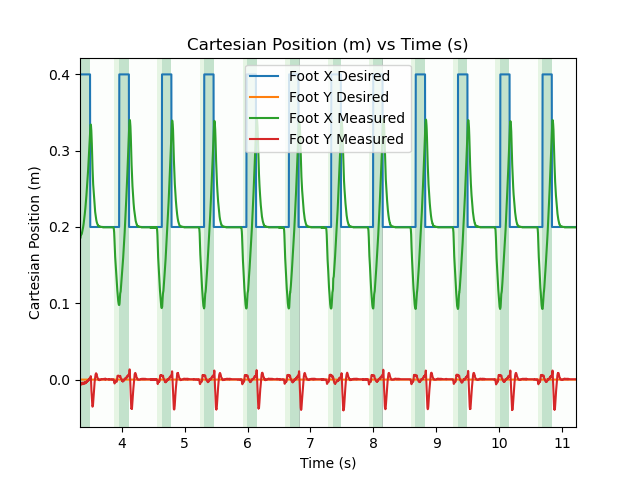
sim/results/20210722_hopping_correctphases/cartesian_position.png
