alopezrivera/hopping_leg/sim/results/20210722_hopping_correctphases/cartesian_velocity.png

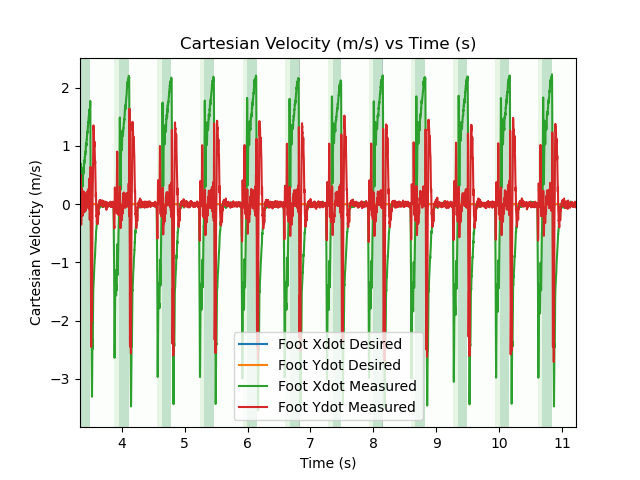
sim/results/20210722_hopping_correctphases/cartesian_velocity.png
