alopezrivera/hopping_leg/sim/results/20210723_energy_shaping/height.png

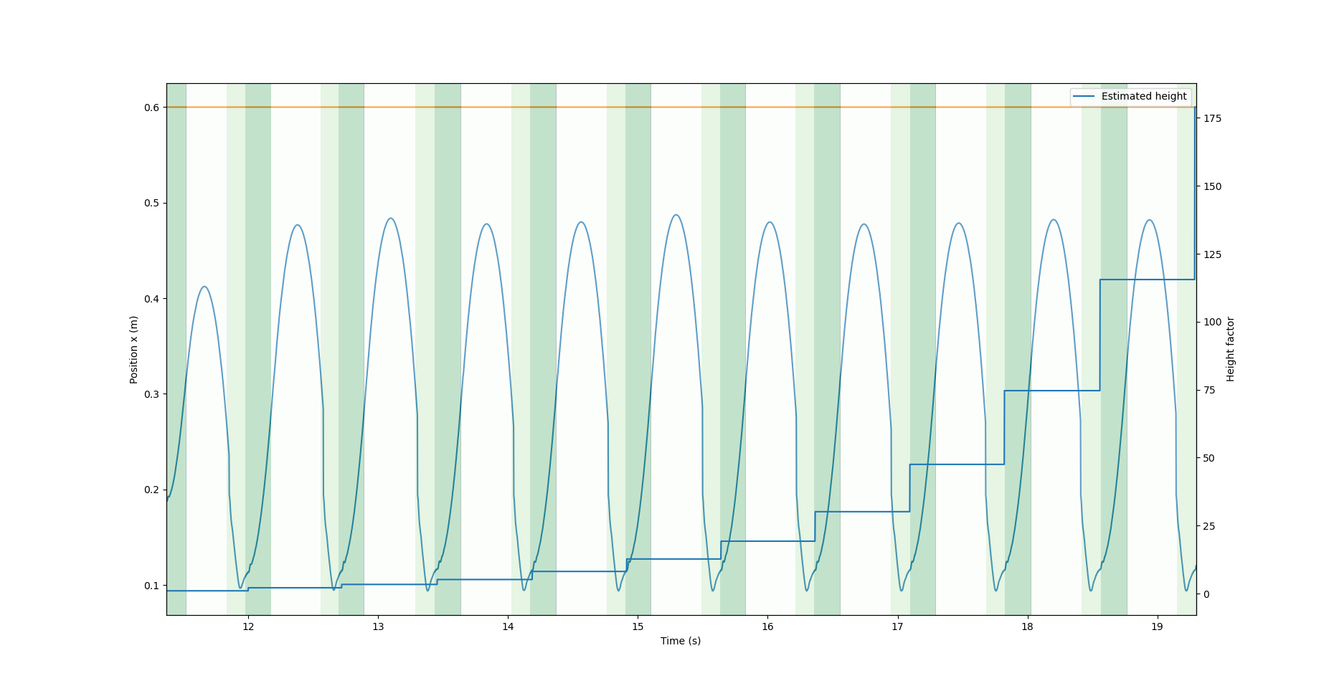
sim/results/20210723_energy_shaping/height.png
