alopezrivera/hopping_leg/sim/results/20210726_energy_shaping/cartesian_velocity.png

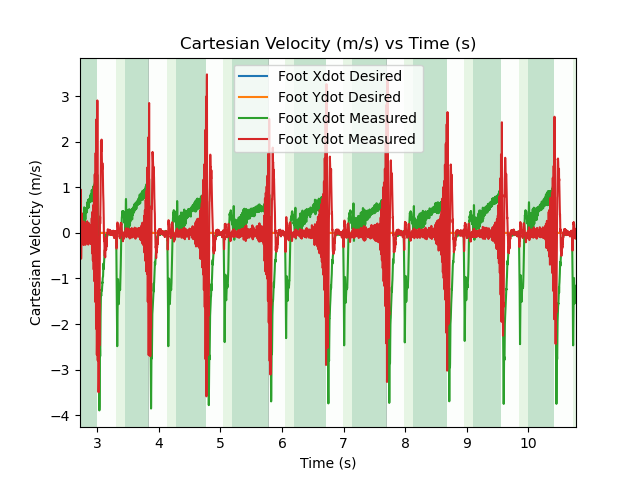
sim/results/20210726_energy_shaping/cartesian_velocity.png
