alopezrivera/hopping_leg/sim/results/20210726_energy_shaping/position.png

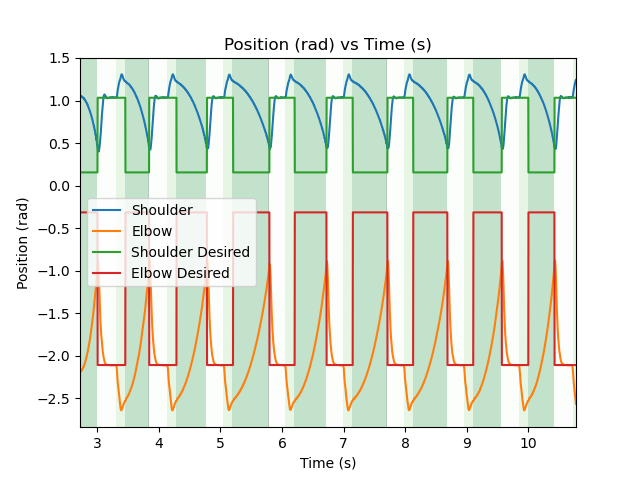
sim/results/20210726_energy_shaping/position.png
