alopezrivera/hopping_leg/sim/results/20210726_energy_shaping/torque.png

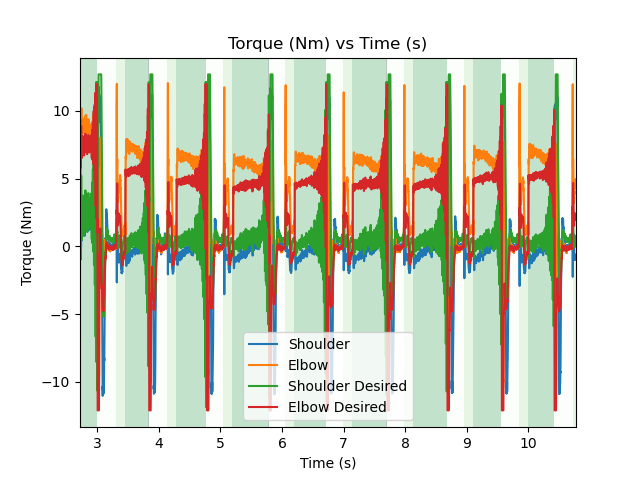
sim/results/20210726_energy_shaping/torque.png
