alopezrivera/hopping_leg/sim/results/20210726_energy_shaping/velocity.png

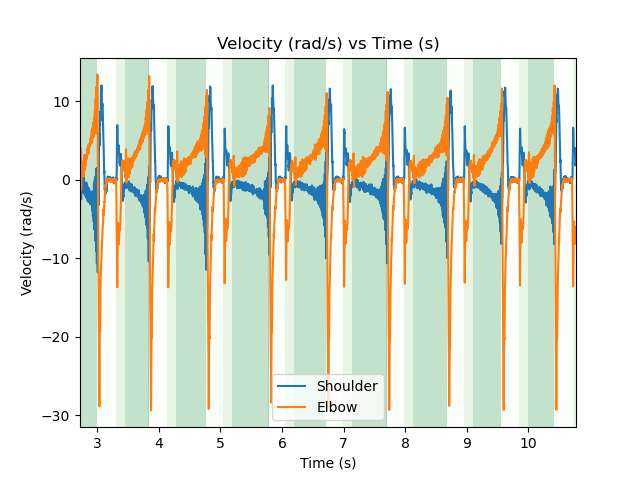
sim/results/20210726_energy_shaping/velocity.png
