alopezrivera/hopping_leg/sim/results/20210726_energy_shaping_0p5m/cartesian_position_XY.png

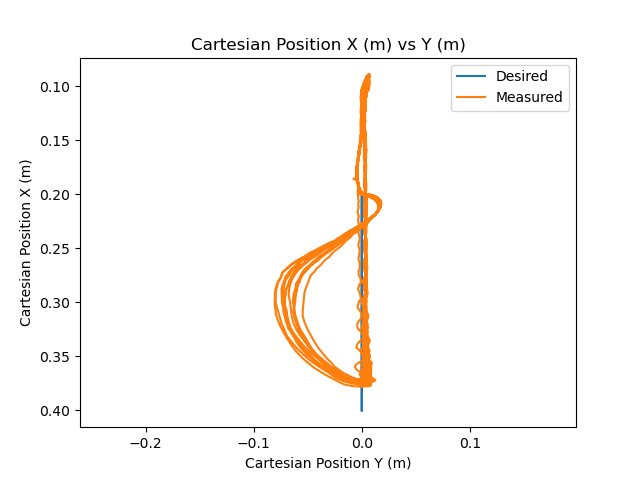
sim/results/20210726_energy_shaping_0p5m/cartesian_position_XY.png
