alopezrivera/hopping_leg/sim/results/20210726_energy_shaping_0p6m/position.png

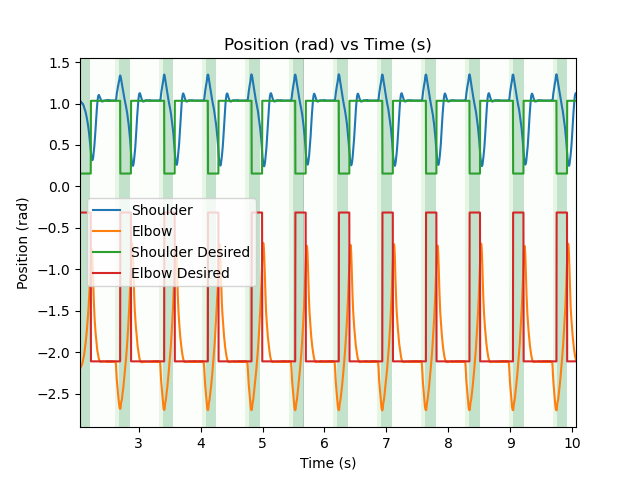
sim/results/20210726_energy_shaping_0p6m/position.png
