alopezrivera/hopping_leg/sim/results/backflip_energyshaping_control/2021-07-19 Backflip Simulation no Rail/position.png

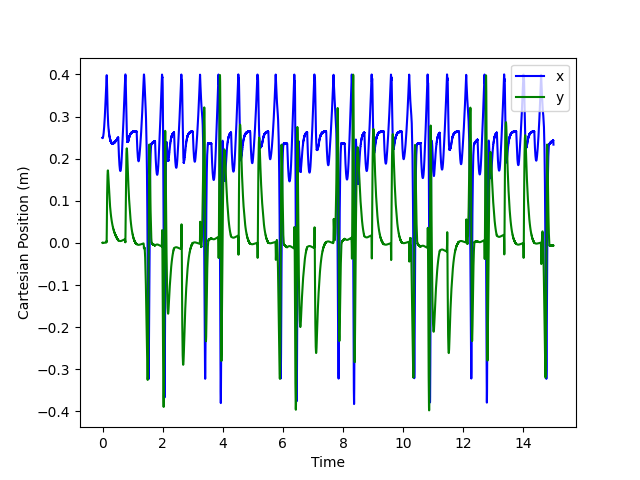
sim/results/backflip_energyshaping_control/2021-07-19 Backflip Simulation no Rail/position.png
