alopezrivera/hopping_leg/sim/results/gainscheduling_control/base_position.png

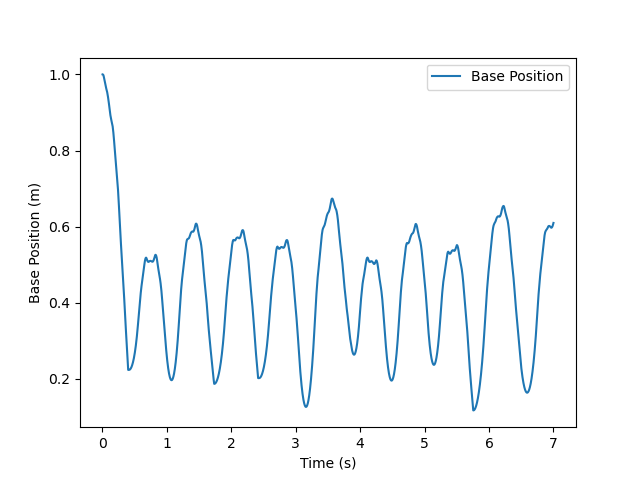
sim/results/gainscheduling_control/base_position.png
