alopezrivera/hopping_leg/sim/results/gainscheduling_control/joint_angles.png

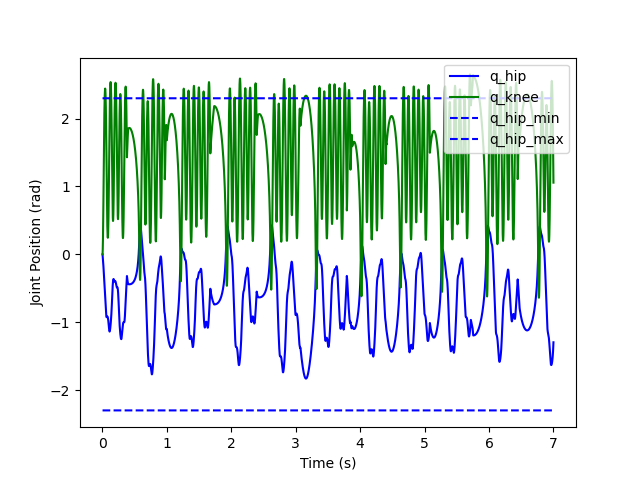
sim/results/gainscheduling_control/joint_angles.png
