alopezrivera/hopping_leg/sim/results/gainscheduling_control/joint_efforts.png

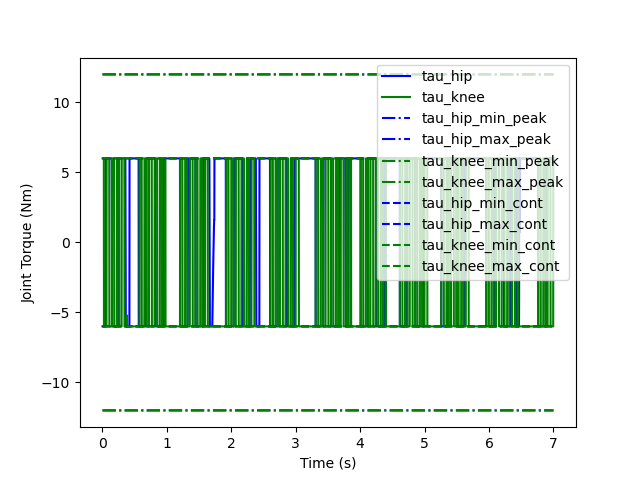
sim/results/gainscheduling_control/joint_efforts.png
