alopezrivera/hopping_leg/sim/results/gainscheduling_control/joint_velocities.png

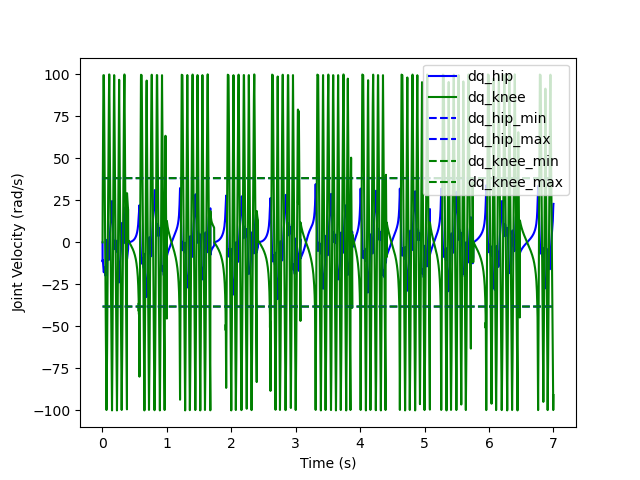
sim/results/gainscheduling_control/joint_velocities.png
