alopezrivera/hopping_leg/sim/results/gainscheduling_control/position.png

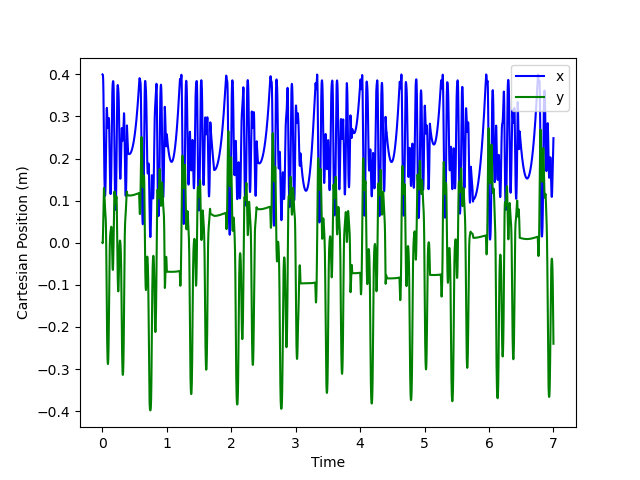
sim/results/gainscheduling_control/position.png
