alopezrivera/hopping_leg/sim/results/gainscheduling_control/reaction_forces.png

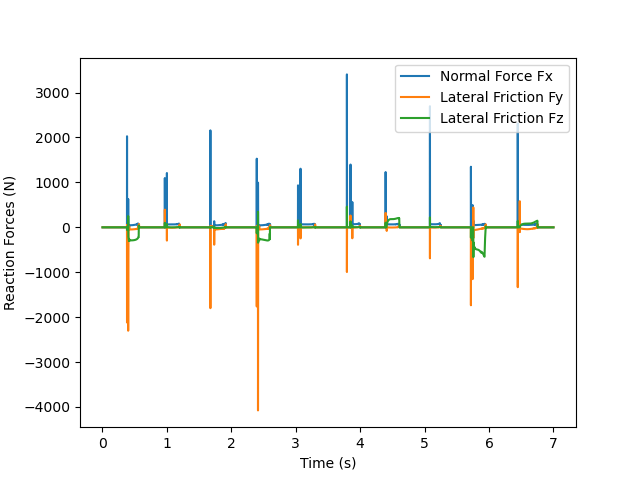
sim/results/gainscheduling_control/reaction_forces.png
