alopezrivera/hopping_leg/sim/results/gainscheduling_control/trajectory.png

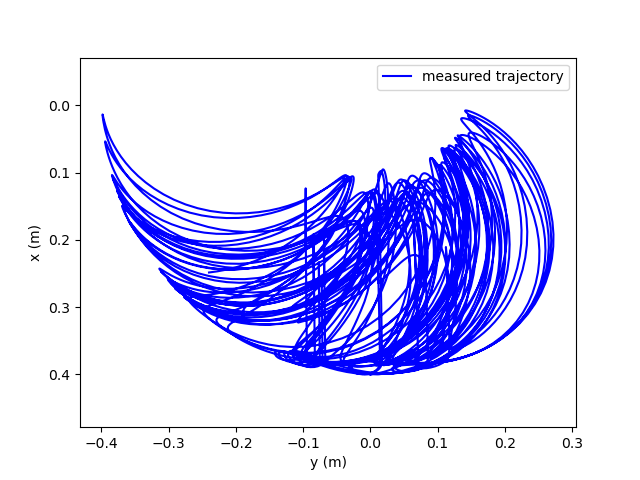
sim/results/gainscheduling_control/trajectory.png
