alopezrivera/hopping_leg/sim/results/gainscheduling_control/velocity.png

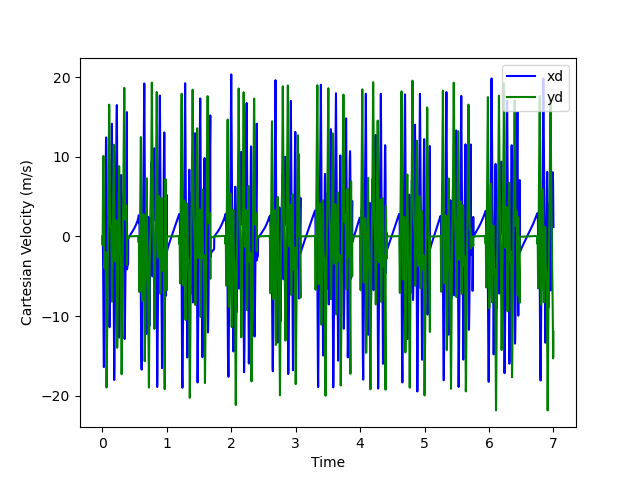
sim/results/gainscheduling_control/velocity.png
