alopezrivera/hopping_leg/sim/results/position_control/joint_angles.png

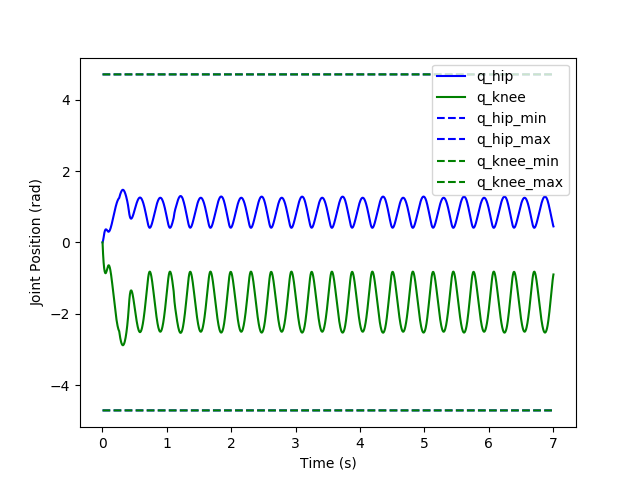
sim/results/position_control/joint_angles.png
