alopezrivera/hopping_leg/sim/results/position_control/joint_efforts.png

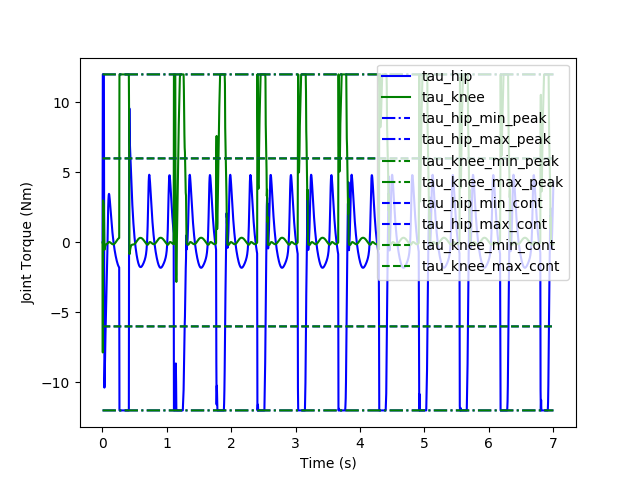
sim/results/position_control/joint_efforts.png
