alopezrivera/hopping_leg/sim/results/position_control/joint_velocities.png

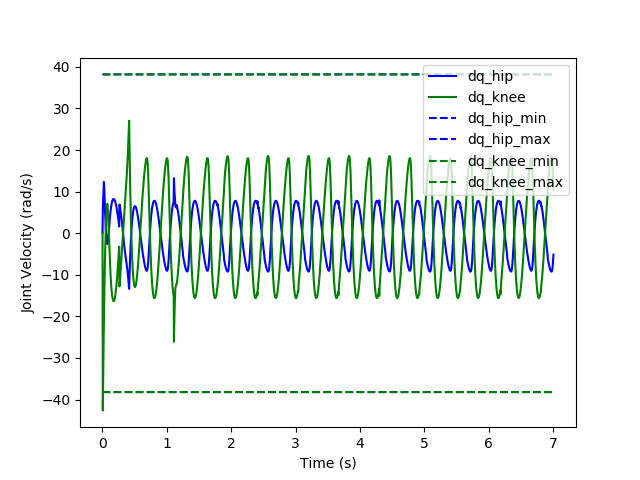
sim/results/position_control/joint_velocities.png
