alopezrivera/hopping_leg/sim/results/position_control/position.png

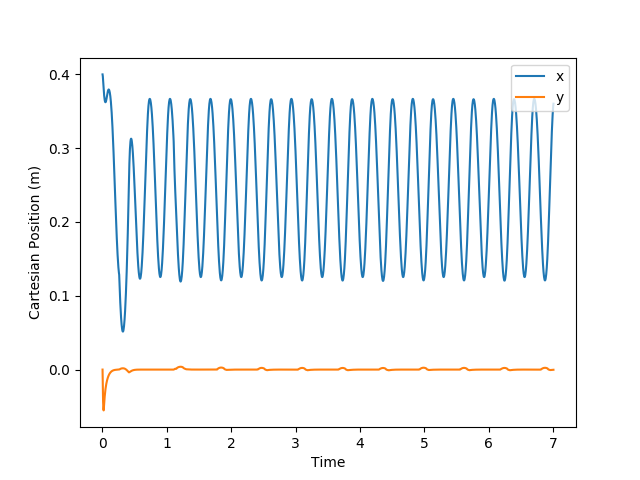
sim/results/position_control/position.png
