alopezrivera/hopping_leg/sim/results/position_control/reaction_forces.png

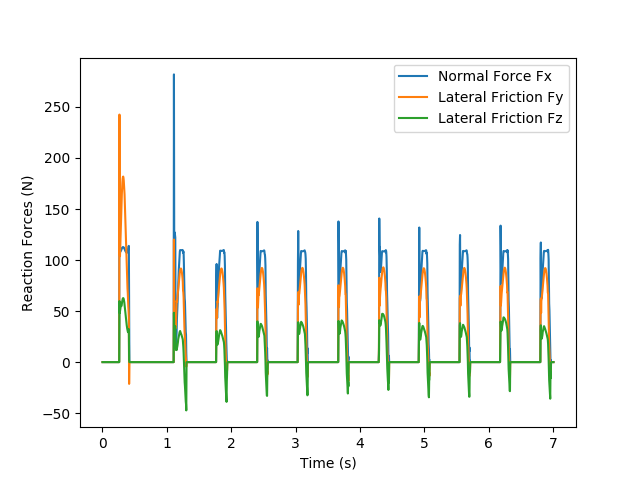
sim/results/position_control/reaction_forces.png
