alopezrivera/hopping_leg/sim/results/simple_hopping/cartesian_position.png

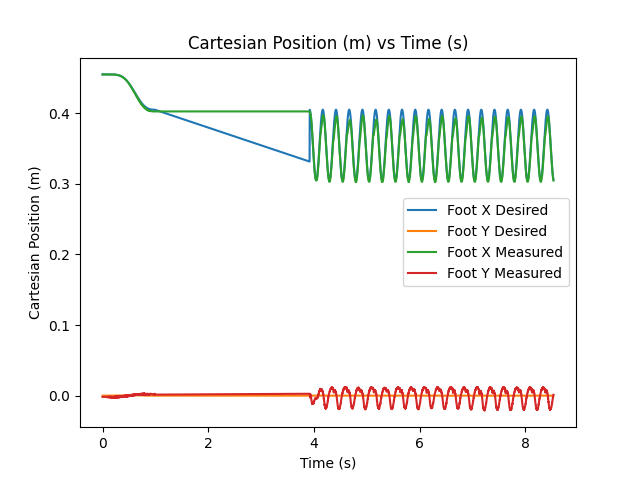
sim/results/simple_hopping/cartesian_position.png
