alopezrivera/hopping_leg/sim/results/simple_hopping/cartesian_position_XY.png

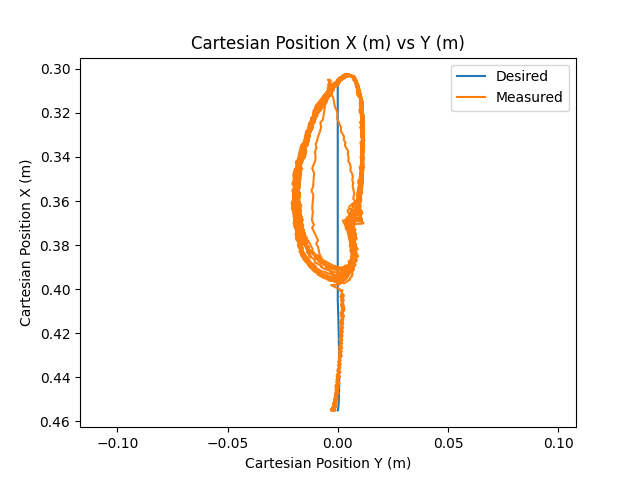
sim/results/simple_hopping/cartesian_position_XY.png
