alopezrivera/hopping_leg/sim/results/simple_hopping/cartesian_velocity.png

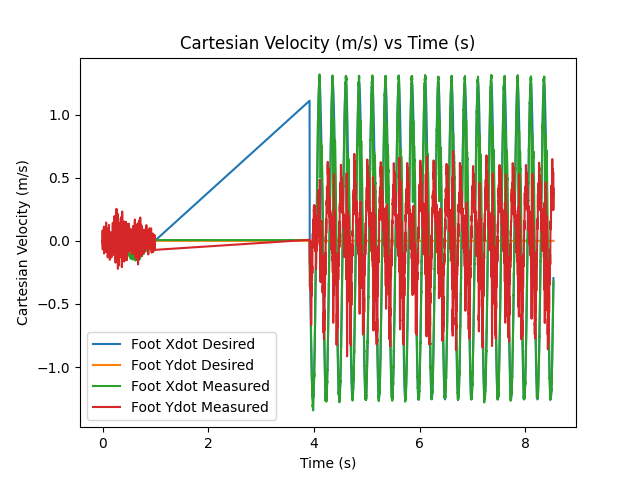
sim/results/simple_hopping/cartesian_velocity.png
