alopezrivera/hopping_leg/sim/results/simple_hopping/filtered_torque.png

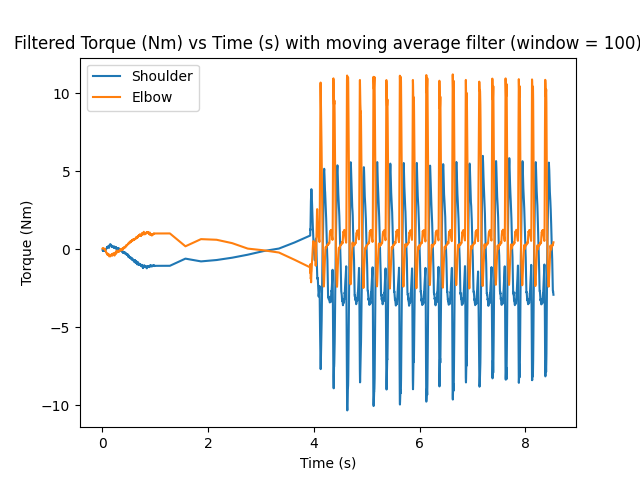
sim/results/simple_hopping/filtered_torque.png
