alopezrivera/hopping_leg/sim/results/simple_hopping/position.png

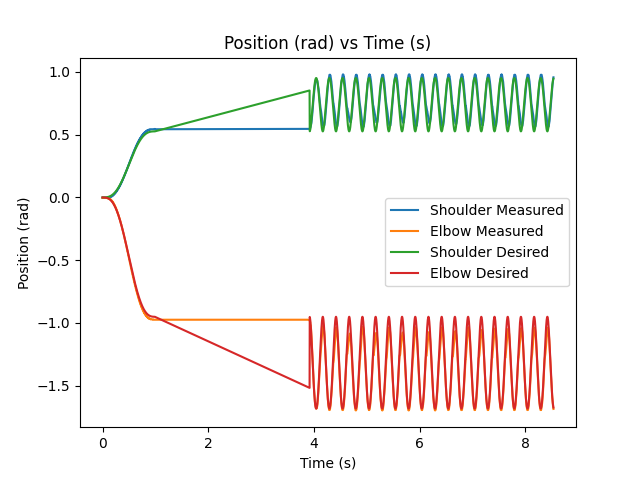
sim/results/simple_hopping/position.png
