alopezrivera/hopping_leg/sim/results/simple_hopping/torque.png

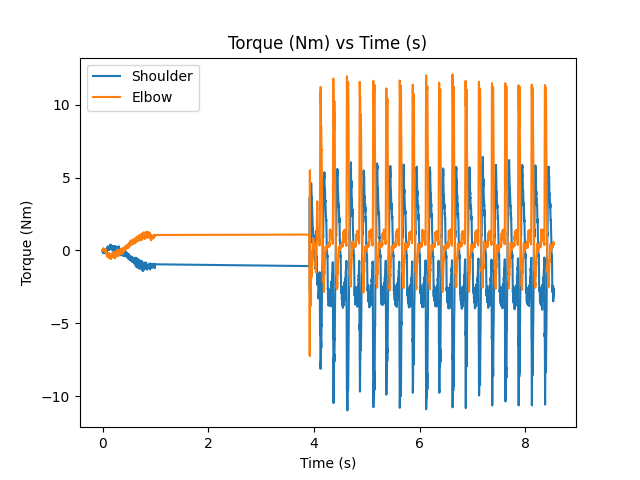
sim/results/simple_hopping/torque.png
