alopezrivera/hopping_leg/sim/results/simple_hopping/velocity.png

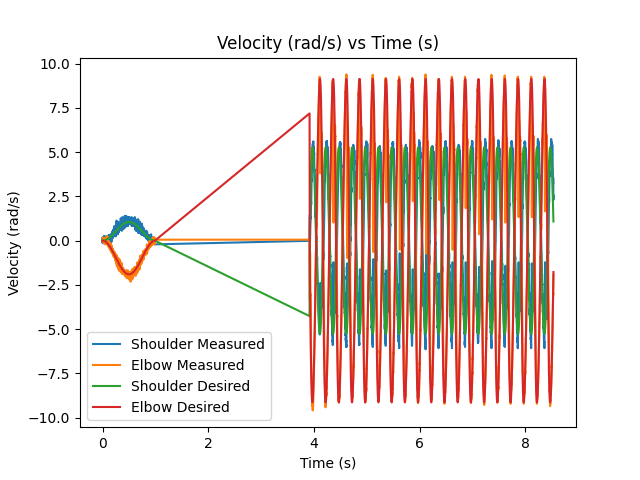
sim/results/simple_hopping/velocity.png
