alopezrivera/hopping_leg/sim/results/simple_hopping_2/cartesian_velocity.png

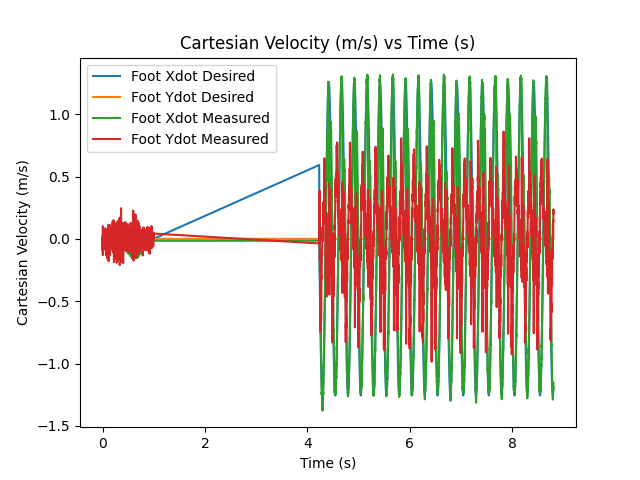
sim/results/simple_hopping_2/cartesian_velocity.png
