alopezrivera/hopping_leg/sim/results/simple_hopping_2/filtered_torque.png

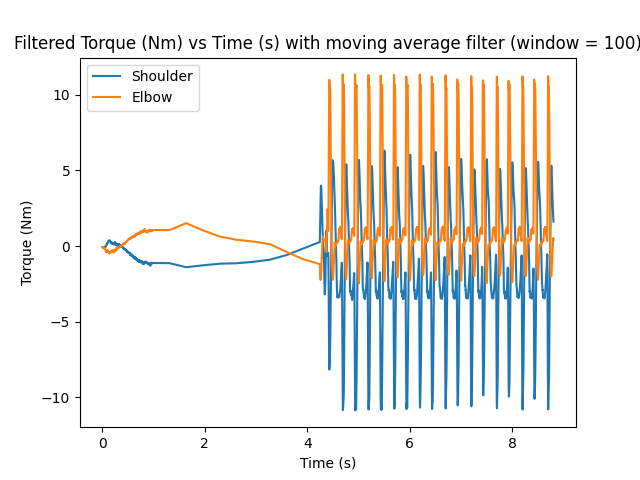
sim/results/simple_hopping_2/filtered_torque.png
