alopezrivera/hopping_leg/sim/results/simple_hopping_2/position.png

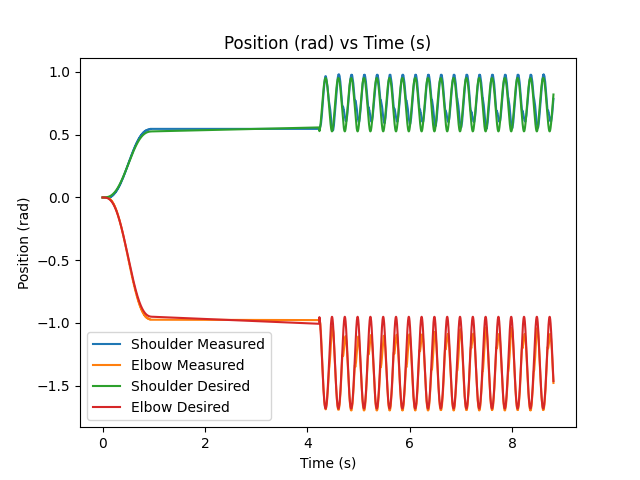
sim/results/simple_hopping_2/position.png
