alopezrivera/hopping_leg/sim/results/simple_hopping_2/torque.png

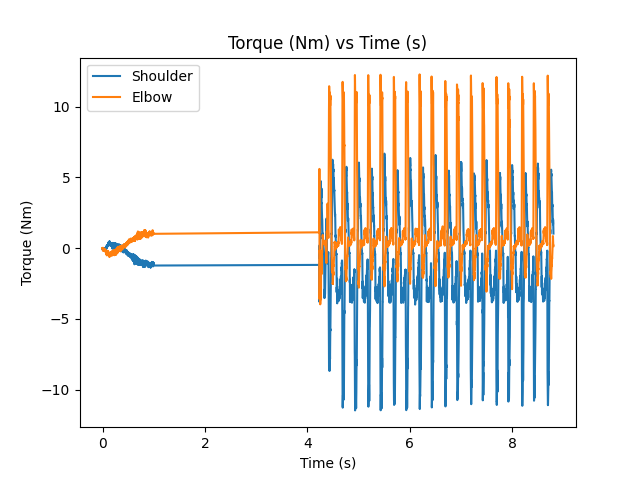
sim/results/simple_hopping_2/torque.png
