alopezrivera/hopping_leg/sim/results/simple_hopping_2/velocity.png

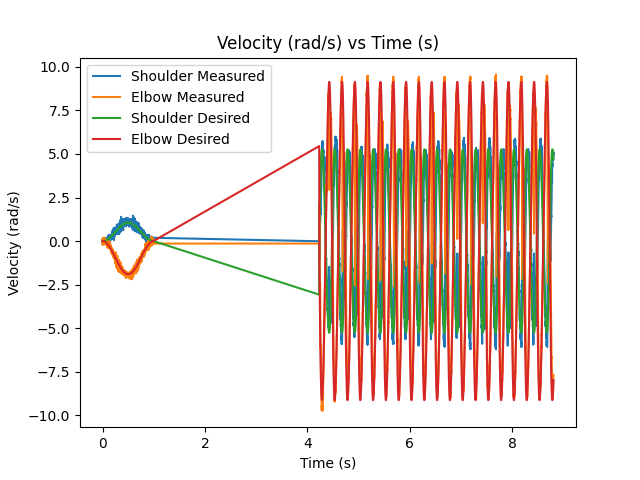
sim/results/simple_hopping_2/velocity.png
