alopezrivera/hopping_leg/sim/results/simple_hopping_foam/cartesian_position.png

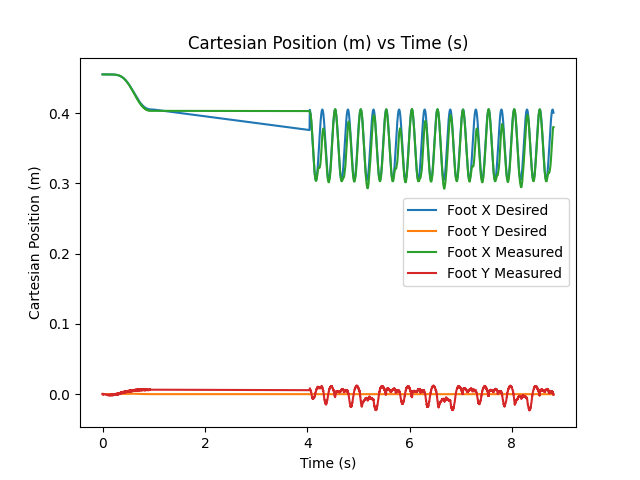
sim/results/simple_hopping_foam/cartesian_position.png
