alopezrivera/hopping_leg/sim/results/simple_hopping_foam/cartesian_velocity.png

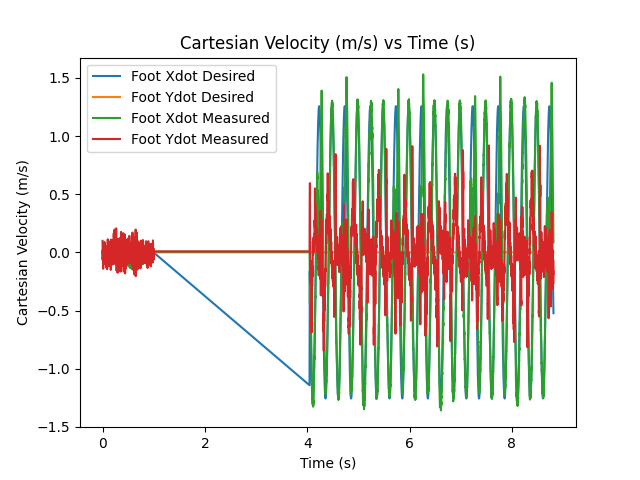
sim/results/simple_hopping_foam/cartesian_velocity.png
