alopezrivera/hopping_leg/sim/results/simple_hopping_foam/filtered_torque.png

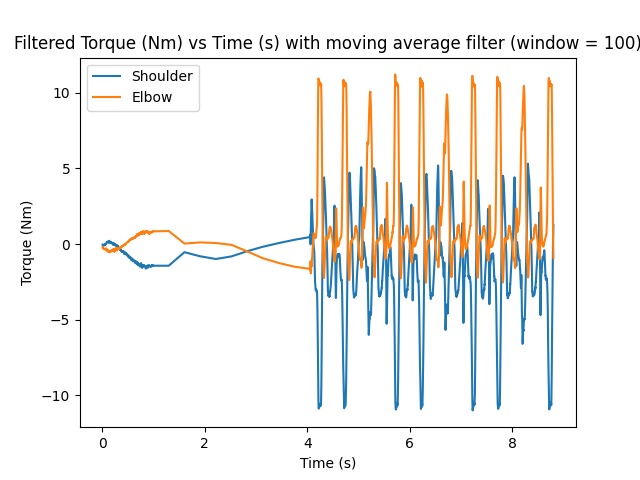
sim/results/simple_hopping_foam/filtered_torque.png
