alopezrivera/hopping_leg/sim/results/simple_hopping_foam/position.png

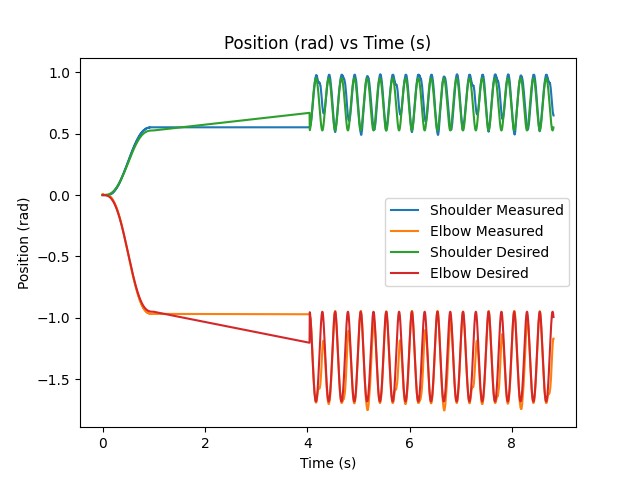
sim/results/simple_hopping_foam/position.png
