alopezrivera/hopping_leg/sim/results/simple_hopping_foam/torque.png

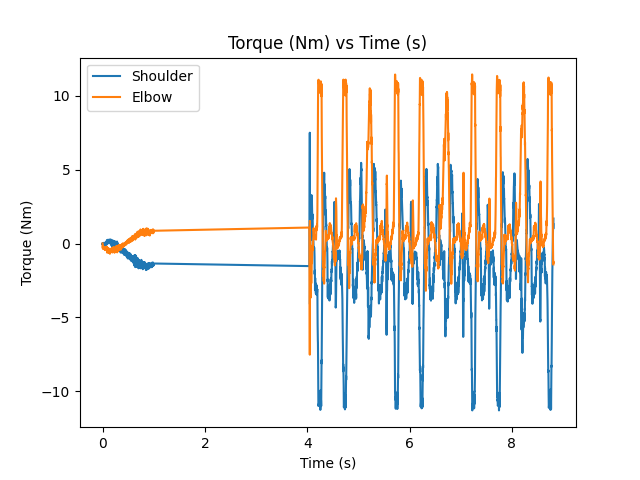
sim/results/simple_hopping_foam/torque.png
