alopezrivera/hopping_leg/sim/results/simple_hopping_iron_weight/cartesian_velocity.png

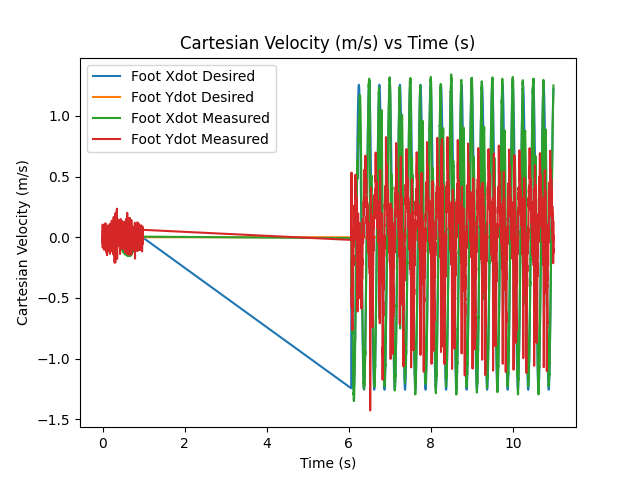
sim/results/simple_hopping_iron_weight/cartesian_velocity.png
