alopezrivera/hopping_leg/sim/results/simple_hopping_iron_weight/filtered_torque.png

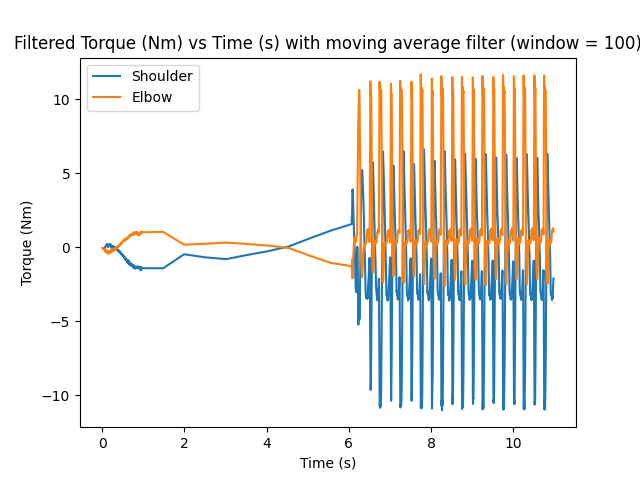
sim/results/simple_hopping_iron_weight/filtered_torque.png
