alopezrivera/hopping_leg/sim/results/simple_hopping_iron_weight/position.png

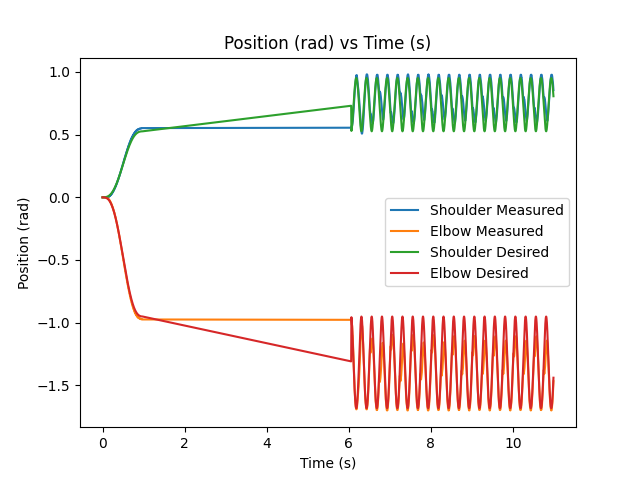
sim/results/simple_hopping_iron_weight/position.png
