alopezrivera/hopping_leg/sim/results/simple_hopping_iron_weight/torque.png

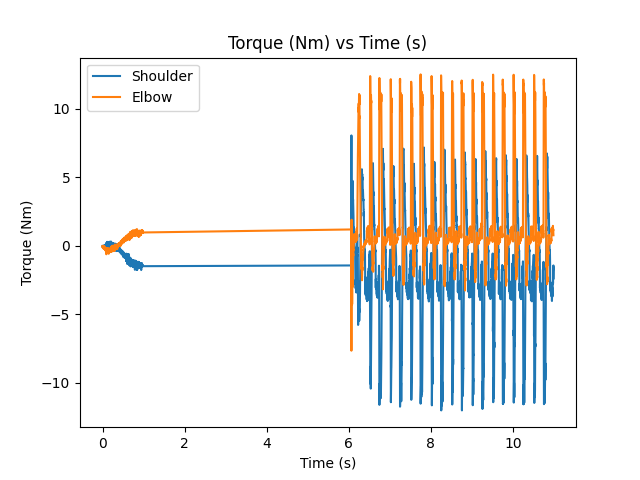
sim/results/simple_hopping_iron_weight/torque.png
