alopezrivera/hopping_leg/sim/results/simple_hopping_iron_weight/velocity.png

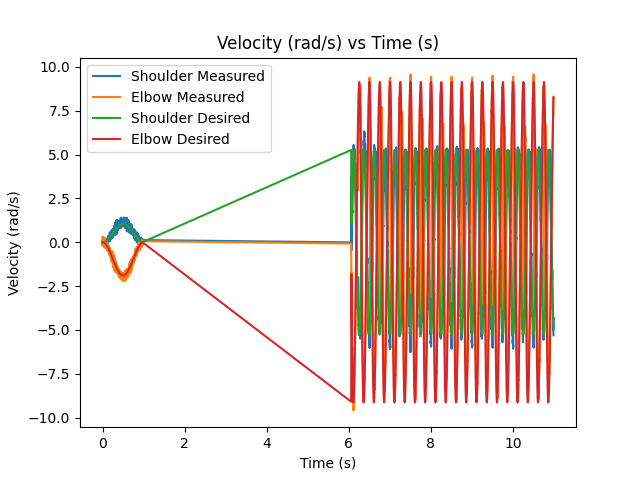
sim/results/simple_hopping_iron_weight/velocity.png
