alopezrivera/hopping_leg/sim/results/torque_control/base_position.png

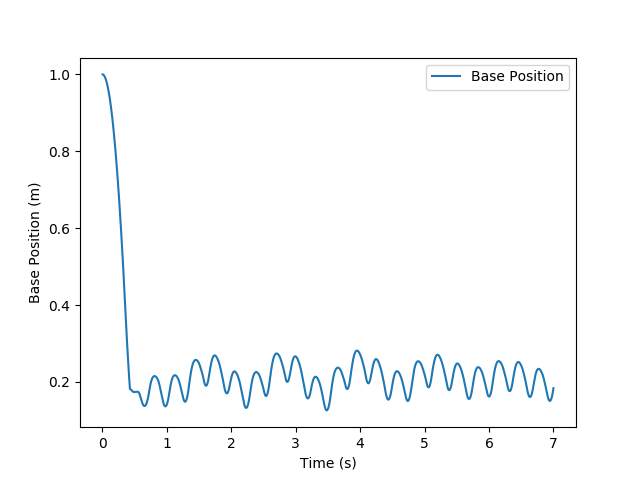
sim/results/torque_control/base_position.png
