alopezrivera/hopping_leg/sim/results/torque_control/joint_angles.png

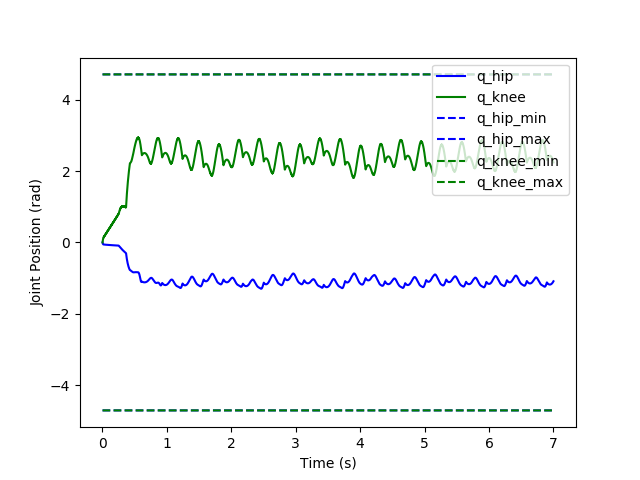
sim/results/torque_control/joint_angles.png
