alopezrivera/hopping_leg/sim/results/torque_control/joint_efforts.png

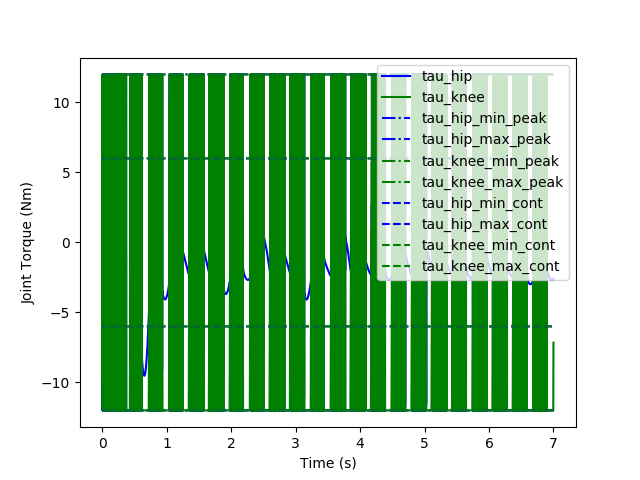
sim/results/torque_control/joint_efforts.png
