alopezrivera/hopping_leg/sim/results/torque_control/joint_velocities.png

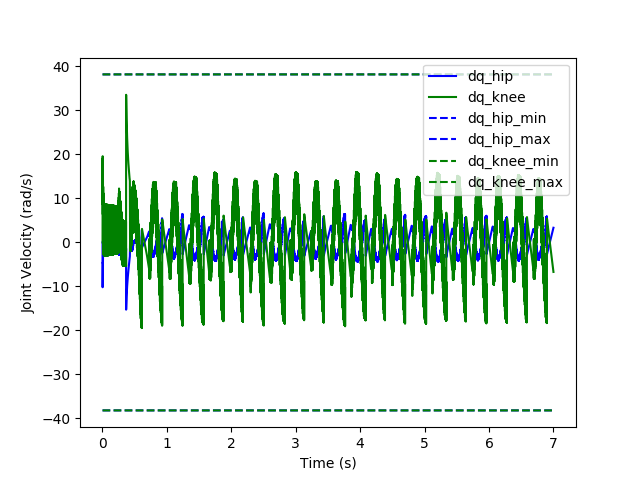
sim/results/torque_control/joint_velocities.png
