alopezrivera/hopping_leg/sim/results/torque_control/position.png

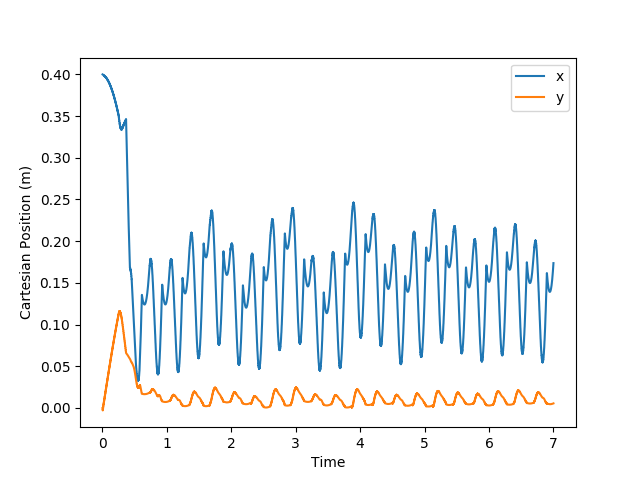
sim/results/torque_control/position.png
