alopezrivera/hopping_leg/sim/results/torque_control/reaction_forces.png

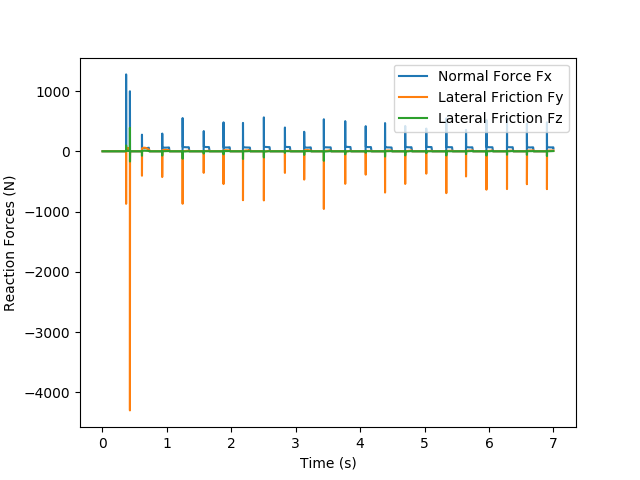
sim/results/torque_control/reaction_forces.png
