alopezrivera/hopping_leg/sim/results/velocity_control/joint_angles.png

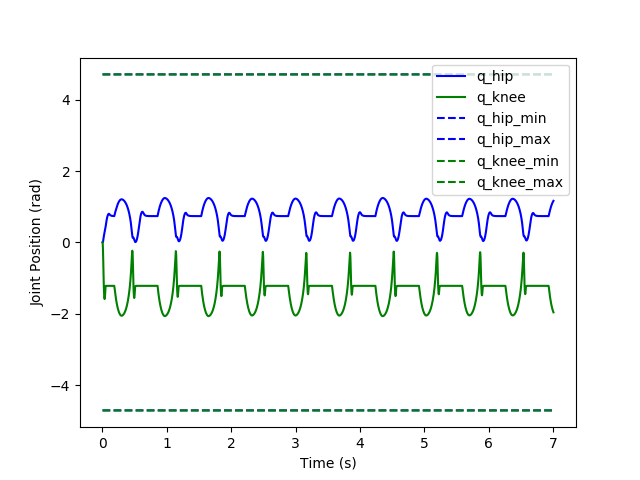
sim/results/velocity_control/joint_angles.png
