alopezrivera/hopping_leg/sim/results/velocity_control/joint_efforts.png

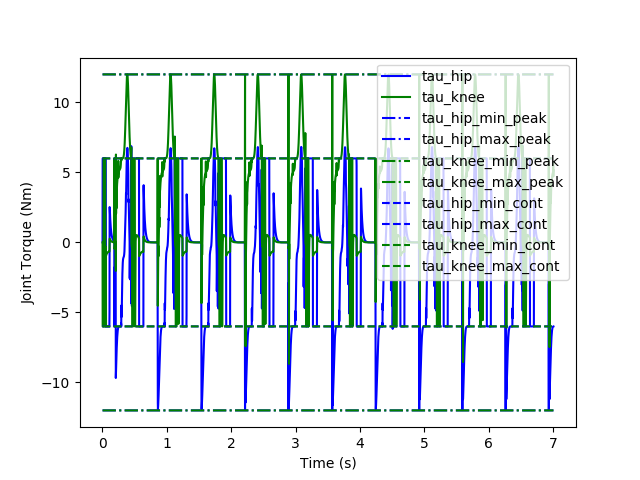
sim/results/velocity_control/joint_efforts.png
