alopezrivera/hopping_leg/sim/results/velocity_control/joint_velocities.png

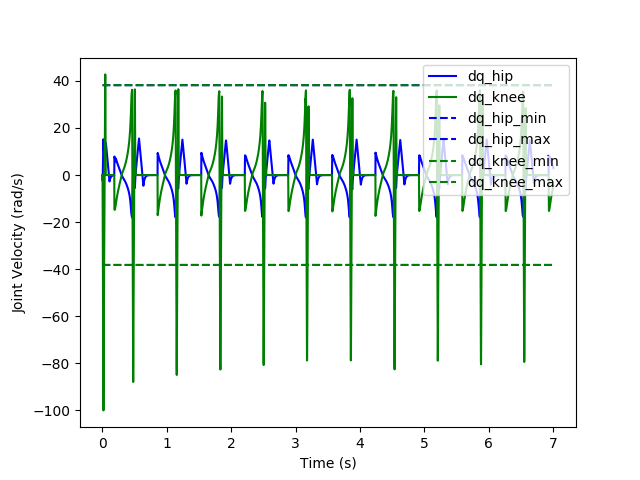
sim/results/velocity_control/joint_velocities.png
