alopezrivera/hopping_leg/sim/results/velocity_control/position.png

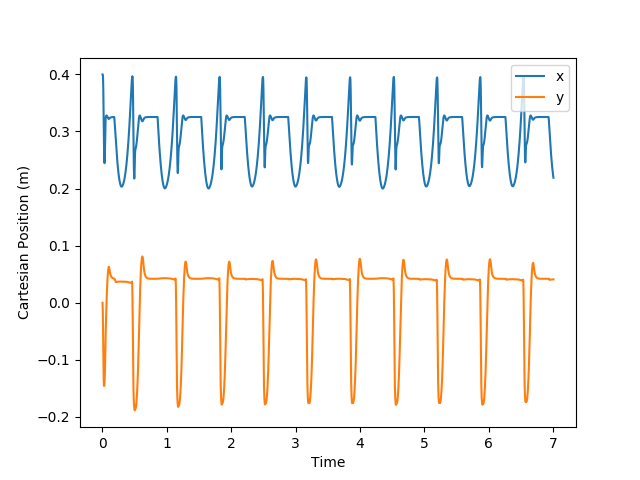
sim/results/velocity_control/position.png
