alopezrivera/hopping_leg/sim/results/velocity_control/reaction_forces.png

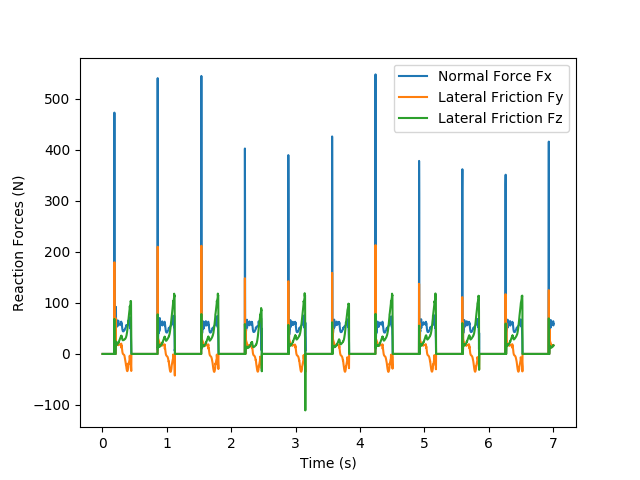
sim/results/velocity_control/reaction_forces.png
