alopezrivera/hopping_leg/sim/results/vertical_traj_test_T0p5/cartesian_position.png

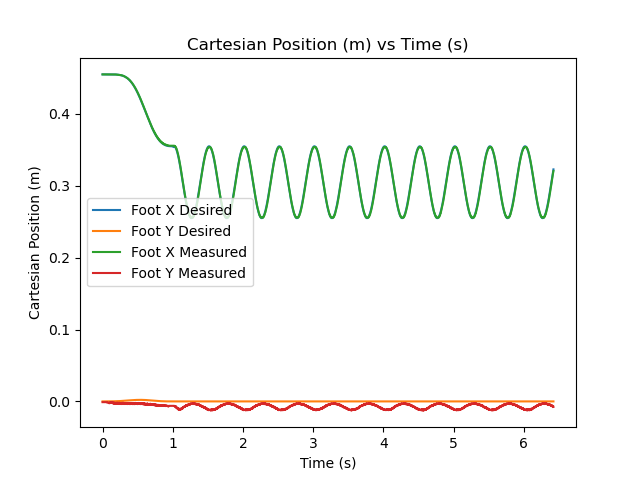
sim/results/vertical_traj_test_T0p5/cartesian_position.png
