alopezrivera/hopping_leg/sim/results/vertical_traj_test_T0p5/torque.png

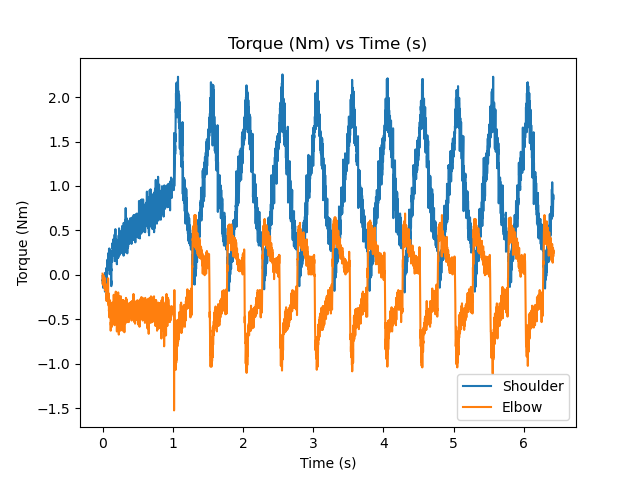
sim/results/vertical_traj_test_T0p5/torque.png
