alopezrivera/hopping_leg/sim/results/vertical_traj_test_T0p25/cartesian_velocity.png

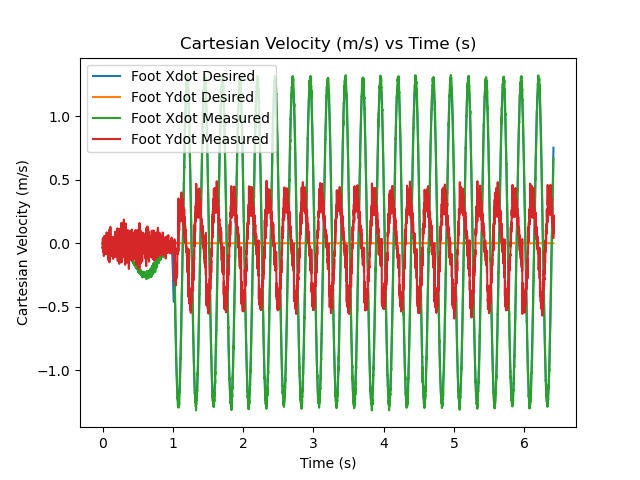
sim/results/vertical_traj_test_T0p25/cartesian_velocity.png
