alopezrivera/hopping_leg/sim/results/vertical_traj_test_T0p25/velocity.png

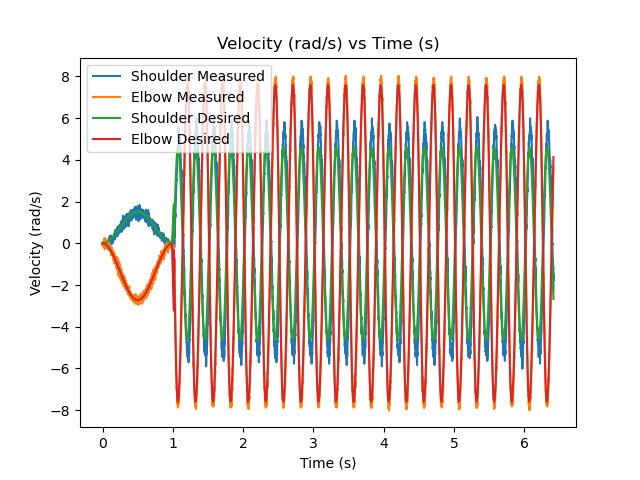
sim/results/vertical_traj_test_T0p25/velocity.png
