alopezrivera/hopping_leg/sim/results/vertical_traj_test_T0p125/cartesian_position.png

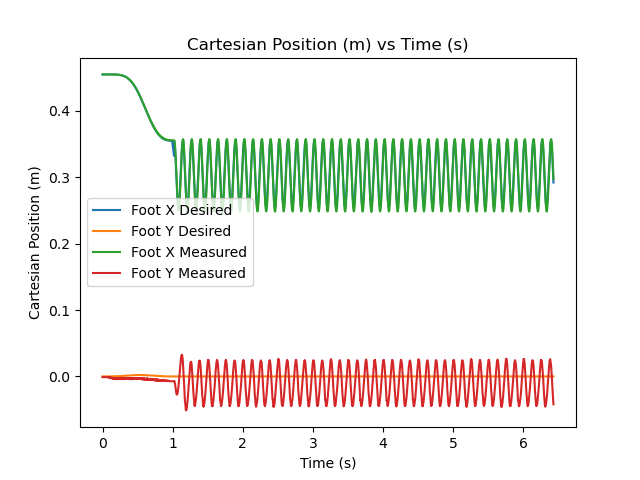
sim/results/vertical_traj_test_T0p125/cartesian_position.png
