alopezrivera/hopping_leg/sim/results/vertical_traj_test_T1_contact/filtere_torque.png

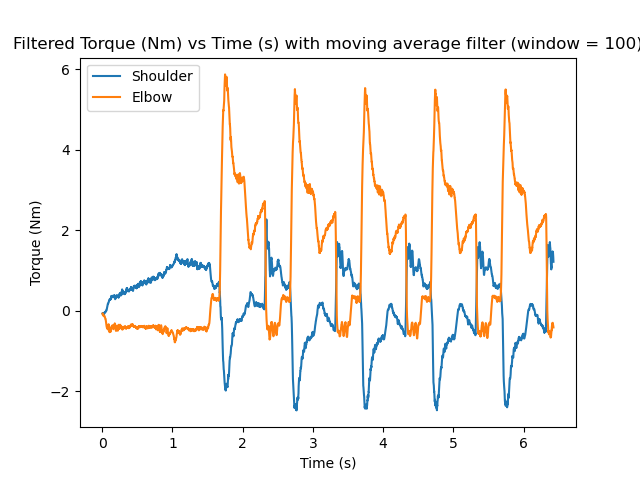
sim/results/vertical_traj_test_T1_contact/filtere_torque.png
