alopezrivera/hopping_leg/sim/results/vertical_traj_test_T1_contact/torque.png

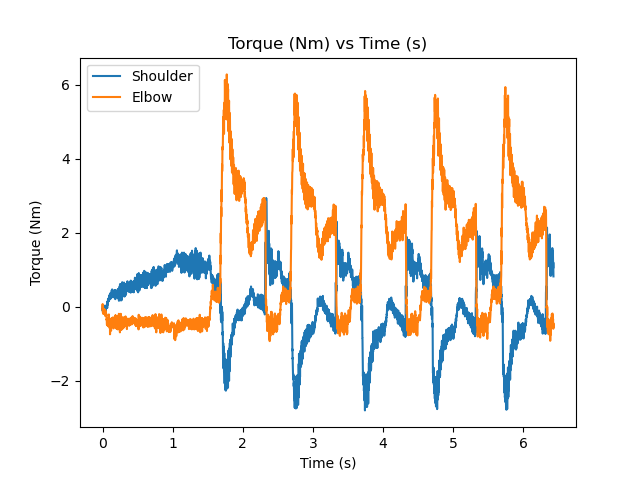
sim/results/vertical_traj_test_T1_contact/torque.png
