alopezrivera/hopping_leg/sim/results/vertical_traj_test_T1_contact/velocity.png

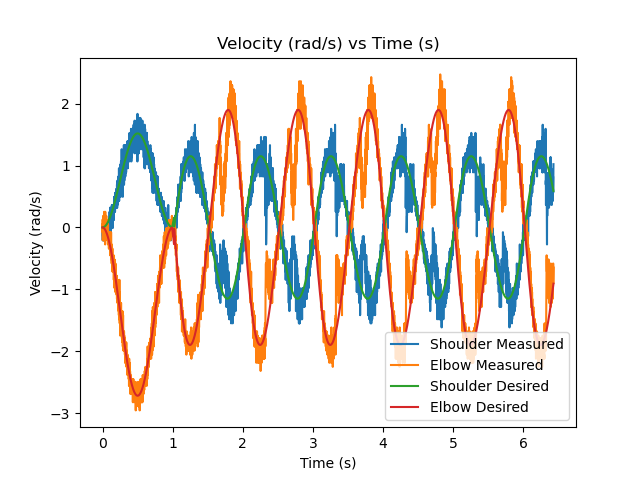
sim/results/vertical_traj_test_T1_contact/velocity.png
