alopezrivera/hopping_leg/sim/results/vertical_traj_test_T1p0/filtered_torque.png

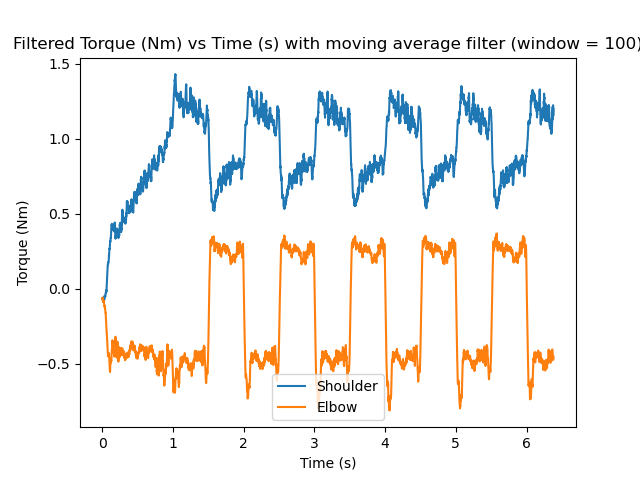
sim/results/vertical_traj_test_T1p0/filtered_torque.png
