alopezrivera/hopping_leg/sim/results/vertical_traj_test_T1p0/torque.png

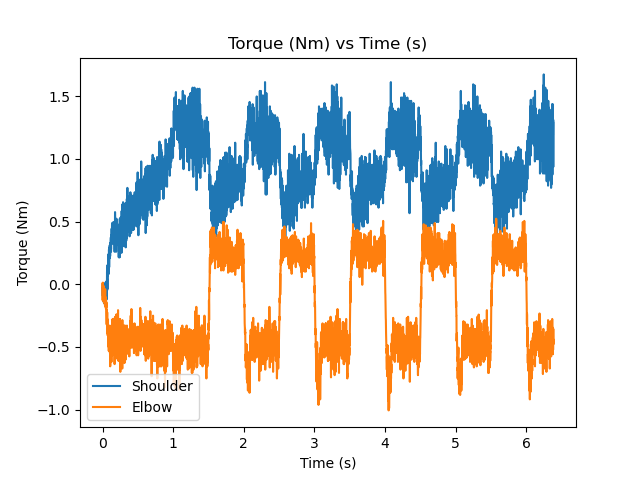
sim/results/vertical_traj_test_T1p0/torque.png
