alopezrivera/hopping_leg/docs/report/figures/phase_diagram_real_system.pdf

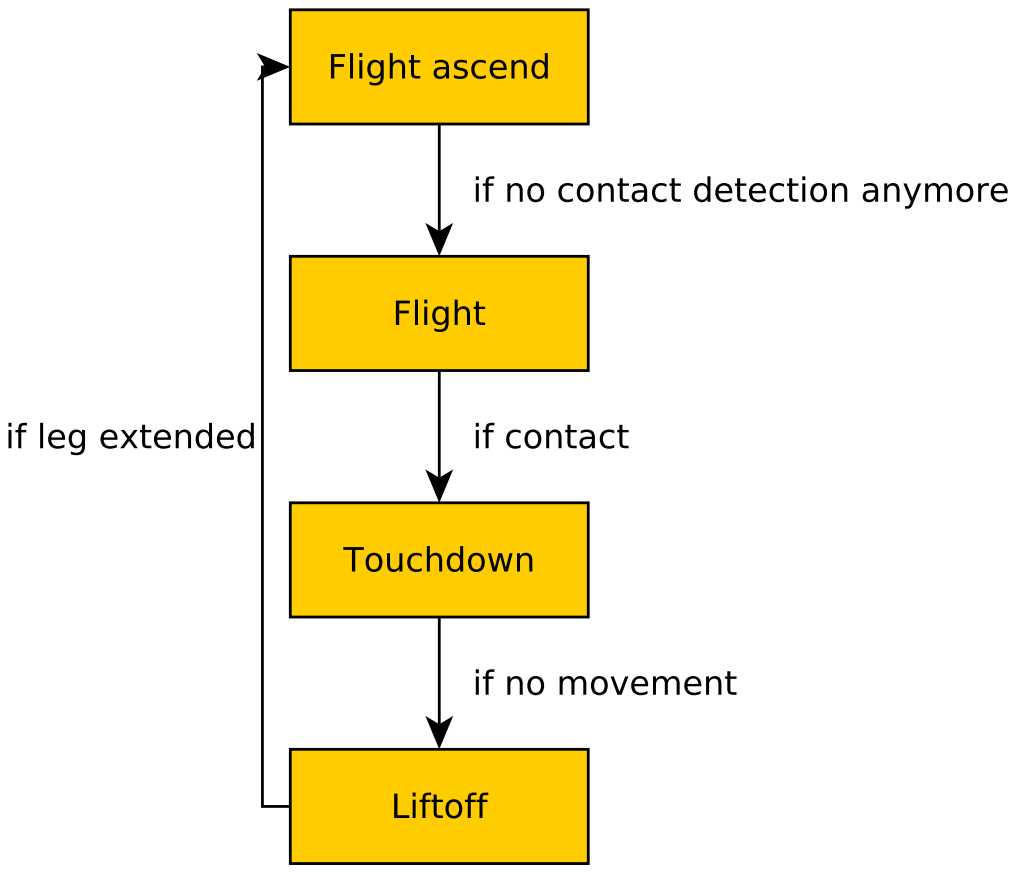
[picture p216: page 1]
