alopezrivera/hopping_leg/docs/report/figures/phase_diagram_simulation.pdf

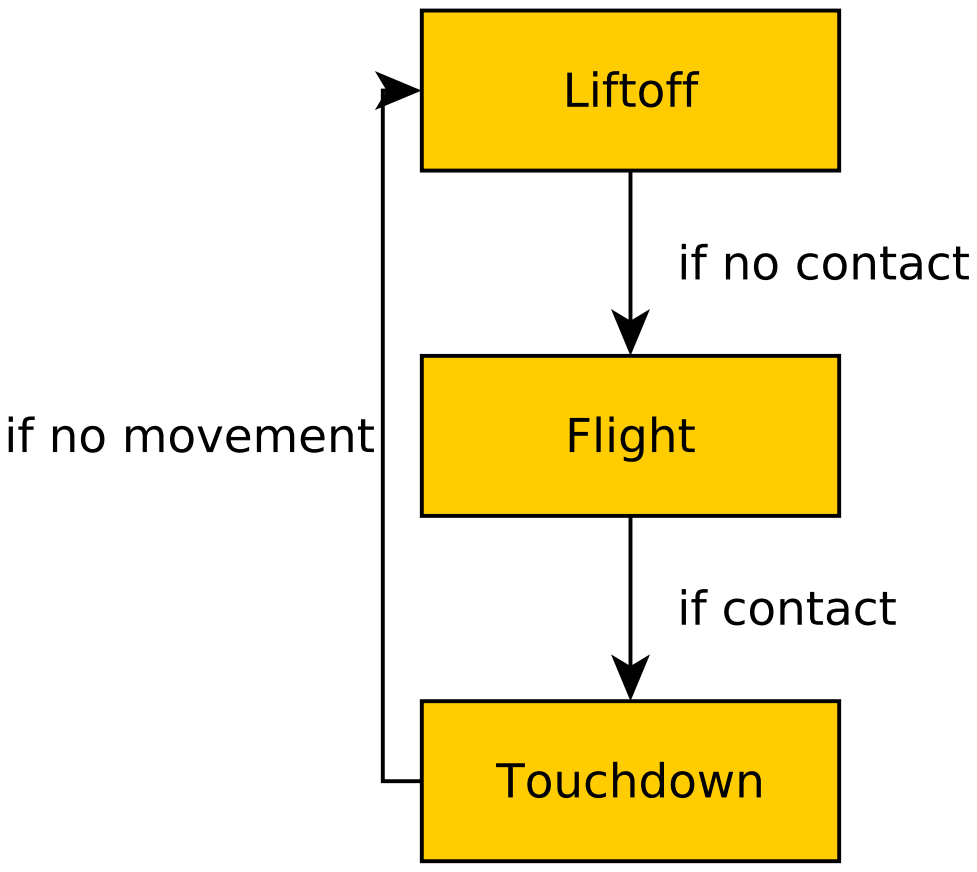
[picture p217: page 1]
